KaykyCrespo/cinto-inteligente-deteccao-quedas/README.md

# Cinto Inteligente: detecção de queda e localização indoor (TCC MVP)

O cinto (ESP32-C3 + MPU6050 + AD8232) envia leituras cruas a 100 Hz por BLE (GATT) para uma antena,
que repassa por MQTT. As demais antenas escutam os anúncios BLE e medem RSSI. No PC, o painel Streamlit
monta janelas de 2,5 s, calcula 8 características, roda um Random Forest treinado no SisFall, estima o
quadrante do ambiente, dispara alerta no Telegram e persiste tudo em SQLite.

## Onde está cada documentação

| Arquivo | Conteúdo |
|---|---|
| `README.md` (este) | Visão geral, estrutura, instalação e execução |
| [`Arduino/README_FIRMWARE.md`](Arduino/README_FIRMWARE.md) | Firmware do cinto e da antena: protocolo BLE/MQTT, configuração, Mosquitto |
| [`dados/README_BANCO_DE_DADOS.md`](dados/README_BANCO_DE_DADOS.md) | Banco SQLite: DER, modelos lógico e físico, dicionário de dados |
| [`docs/MANUAL/Manual_Usuario_Operacao_Revisado.pdf`](docs/MANUAL/Manual_Usuario_Operacao_Revisado.pdf) | Guia do Usuário e Manual de Operação revisado (fonte: `docs/MANUAL/MANUAL_USUARIO_OPERACAO.md`) |
| [`docs/impressao_3d`](docs/impressao_3d/) | Projetos `Case Cinto.3mf` e `Case Antena.3mf` para impressão dos cases |
| [`dados/testes`](dados/testes/) | Registros e vídeos de testes; limites de comprovação e rastreabilidade na Seção 5.6 do manual |
| [`docs/VIDEO TECNICO/Roteiro_Video.pdf`](docs/VIDEO%20TECNICO/Roteiro_Video.pdf) | Roteiro e materiais do vídeo técnico (fonte: `docs/VIDEO TECNICO/ROTEIRO_VIDEO.md`) |
| [`docs/gerar_documentos.py`](docs/gerar_documentos.py) | Gera o manual ou o roteiro em DOCX e PDF |
| [`dados/SISFALL/README_ORIGEM_SISFALL.md`](dados/SISFALL/README_ORIGEM_SISFALL.md) | Nota original sobre a origem do dataset SisFall (terceiros) |
| `dados/SISFALL/SisFall_dataset/Readme.txt` | Descrição oficial do SisFall (atividades, voluntários, sensores) |

## Estrutura do projeto

```
TCC MVP/
├── app.py                 painel Streamlit (ponto de entrada)
├── alerta_telegram.py     envio de alertas pelo bot do Telegram
├── banco.py               persistência SQLite (sessões, amostras, janelas, quedas, status)
├── detector_queda.py      janelas + Random Forest em tempo real
├── features.py            as 8 características (referência para treino e detecção)
├── interface.py           parser do pacote MQTT e monitor de terminal
├── localizacao.py         RSSI -> distância -> quadrante (com confiança e retenção)
├── requirements.txt       dependências do sistema
├── requirements-docs.txt  dependências só para gerar documentos e diagramas
├── Arduino/               firmware do cinto (cinto_mvp_v1), da antena (anchor_mvp_v1) e bibliotecas usadas
├── assets/                logo.svg do painel
├── modelos/               modelo_mvp_8g.joblib e o relatório do treino
├── scripts/               treino_sisfall.py, reproduzir_csv.py
├── tests/                 testes automatizados (localização, controle do Telegram)
├── dados/
│   ├── oqpnb.db           banco SQLite (criado ao abrir o painel; ignorado pelo git)
│   ├── README_BANCO_DE_DADOS.md  DER, modelos e dicionário de dados
│   ├── ambiente.json      tamanho do ambiente e posição das antenas (salvo pelo painel)
│   ├── gravacoes/         CSV de amostras do botão "Gravar amostras" (ignorado pelo git)
│   ├── testes/            registros e vídeos de execução dos testes
│   ├── ensaios_rssi/      CSVs e resultados dos ensaios de calibração de RSSI
│   └── SISFALL/           dataset público usado no treino
└── docs/
    ├── MANUAL/            fonte e arquivos PDF/DOCX do manual
    ├── impressao_3d/      projetos Case Cinto.3mf e Case Antena.3mf
    ├── VIDEO TECNICO/     roteiro, gravações e arquivos PDF/DOCX
    ├── gerar_documentos.py gera o manual e o roteiro em DOCX/PDF
    ├── Power Point - Apresentação.pptx
    ├── esquemas/          diagramas (arquitetura, pipeline, métricas) e seus scripts
    ├── APOIO/             material de apoio do curso
    └── IMAGENS/           cases, fluxograma e capturas do painel
```

Os módulos Python da raiz se importam entre si pelo nome; mantenha-os juntos. Scripts e testes
ajustam o `sys.path` sozinhos e podem ser executados de qualquer pasta.

## Instalação e execução

```powershell
git clone https://github.com/KaykyCrespo/cinto-inteligente-deteccao-quedas.git
cd cinto-inteligente-deteccao-quedas

pip install -r requirements.txt

# só para regenerar diagramas e o manual em docs/ (exige Word instalado para o PDF)
pip install -r requirements-docs.txt

# painel (abre http://localhost:8501)
python -m streamlit run app.py

# alerta Telegram (opcional): defina antes de abrir o painel
$env:OQPNB_TG_TOKEN="token do BotFather"; $env:OQPNB_TG_CHAT="chat_id"

# monitor em terminal
python interface.py --modelo modelos/modelo_mvp_8g.joblib --quiet

# reproduzir um CSV gravado sem hardware
python scripts/reproduzir_csv.py dados/gravacoes/amostras_X.csv --modelo modelos/modelo_mvp_8g.joblib

# refazer o treino (~6 min)
python scripts/treino_sisfall.py --sisfall dados/SISFALL/SisFall_dataset --saida modelos/modelo_mvp_8g.joblib

# testes
python -m unittest discover -s tests -p "teste_*.py" -v
```

Variáveis de ambiente opcionais: `OQPNB_BROKER`, `OQPNB_PORT`, `OQPNB_MODELO`, `OQPNB_DB`,
`OQPNB_LARGURA_M`, `OQPNB_ALTURA_M`, `OQPNB_RSSI_1M`, `OQPNB_N_PERDA`, `OQPNB_OFFSET_GATT`.
O tamanho do ambiente e a posição das antenas também podem ser ajustados no painel (mapa da aba
Detalhes); o painel salva em `dados/ambiente.json`, que tem prioridade sobre as variáveis.

Credenciais nunca ficam no código versionado: o token e o chat do Telegram vêm das variáveis
`OQPNB_TG_TOKEN`/`OQPNB_TG_CHAT` ou do arquivo local `segredos.env` (copie de `segredos.env.exemplo`),
e o Wi-Fi das antenas vem de `Arduino/anchor_mvp_v1/credenciais.h` (copie de `credenciais_exemplo.h`).
Os dois arquivos são ignorados pelo git.

As faixas do `iniciarMPU()` no cinto (±8 g / ±2000 °/s) **precisam** ser as mesmas do modelo.
Se mudar alguma, treine de novo com `--faixa-acc` e `--faixa-giro`.

## Painel

- **Monitoramento**: cartão por cinto (status normal / possível queda com data, hora, antena, quadrante
  e contagem regressiva do aviso), broker, amostras, taxa, eletrodos, antenas online, Telegram,
  probabilidade de queda (8 últimas janelas, 0–100 %) e tabela de quedas.
- **Detalhes**: status do sistema (modelo, limiar, pacotes inválidos, amostras perdidas, janelas
  reiniciadas, quantidade de quedas), antenas (GATT/Advertising, RSSI, mais perto), tabela RSSI,
  histórico de quedas, gráficos de sinais, mapa indoor com raios de distância, ECG e exportação.
- **Barra lateral**: envio de alertas no Telegram (toggle + teste), limiar, tempo para resetar o
  aviso de queda (1–5 min), atualização automática, gravação de amostras e reconectar.

## Detecção

Random Forest (200 árvores) treinado offline no SisFall a 100 Hz, ±8 g / ±2000 °/s, validado por
voluntário: 98,8 % das quedas detectadas e 95,3 % de especificidade (limiar 0,5). Detalhes em
`modelos/resultado_treino_mvp_8g.txt`. O modelo não aprende em uso; para incorporar novos dados é
preciso retreinar. Entre dois alarmes do mesmo cinto há um silêncio de 5 s.

## Localização

Estimativa por RSSI das 3 antenas (modelo log-distância), mediana de 4 s, histerese de 0,6 m,
confirmação de 3 s para troca de quadrante e retenção da última posição válida por até 6 s com
baixa confiança. O mapa desenha um círculo por antena com o raio estimado.

Limite conhecido e medido (`dados/ensaios_rssi/RESULTADO_ENSAIOS_RSSI.txt`): com o cinto na frente do corpo,
os ensaios antigos de 1 m com antenas altas mostram uma diferença de cerca de 22 a 24,5 dB
entre a antena de frente e a de costas, compatível com sombreamento, sem isolar outras causas.
Os novos ensaios de 1, 2, 3, 5 e 7 m não mostram queda monotônica de RSSI com a distância nominal;
suas condições de montagem e distâncias até cada antena ainda precisam ser confirmadas.
O relatório reúne estatísticas por antena e origem, agregadas por segundo, sem alterar a calibração.
A trilateração deve ser lida como estimativa de região/quadrante, não de ponto. Próximo passo:
repetir os ensaios com geometria e orientação controladas antes de ajustar o modelo.

## Banco de dados

SQLite em `dados/oqpnb.db`. Janelas, quedas e status das antenas são gravados sempre; amostras
brutas só enquanto "Gravar amostras" estiver ligado. Modelagem completa (DER, lógico, físico,
dicionário de dados) em `dados/README_BANCO_DE_DADOS.md`. A aba Detalhes exporta CSV por sessão e o próprio `.db`.
