KaykyCrespo/cinto-inteligente-deteccao-quedas/docs/Power Point - Apresentação.pptx

UNIP
Ciência da Computação
2026

ORIENTADOR
Prof. Marco Gomes

Vertente SmartCity

Cinto Inteligente com IoT e Inteligência Artificial para Monitoramento de Atividades, Sinais Vitais e Localização Indoor

Sistema de Detecção de Possíveis Quedas

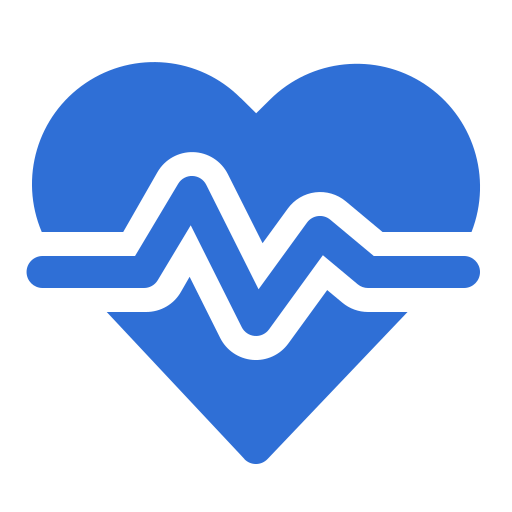
[picture p15: figure]

EQUIPE

Aluisio Pereira Alves (N135891)

Erick de Brito Carvalho (G78HED3)

Enzo Orlandi Gomes (G788EJ5)

Kayky Crespo dos Santos (G839226)

Notes: Boa noite a todos. Somos a equipe formada por Aluisio, Enzo, Erick e Kayky, e apresentamos, sob orientação do professor Marco Gomes, nosso trabalho de conclusão de curso em Ciência da Computação na UNIP. O projeto se chama Cinto Inteligente com IoT e Inteligência Artificial para Monitoramento de Atividades, Sinais Vitais e Localização Indoor, e tem como foco um sistema de detecção de possíveis quedas. Ele se enquadra na vertente SmartCity, porque trata do cuidado com idosos como um serviço urbano apoiado por tecnologia. Nos próximos minutos vamos mostrar o contexto do problema, o que propomos, como fundamentamos a solução e como o protótipo foi construído. Vamos começar pela introdução.

## Slide 2

Quedas de idosos são um desafio urbano

População envelhecendo

Cresce o número de pessoas idosas nas cidades.

Cinto Inteligente – TCC UNIP 2026

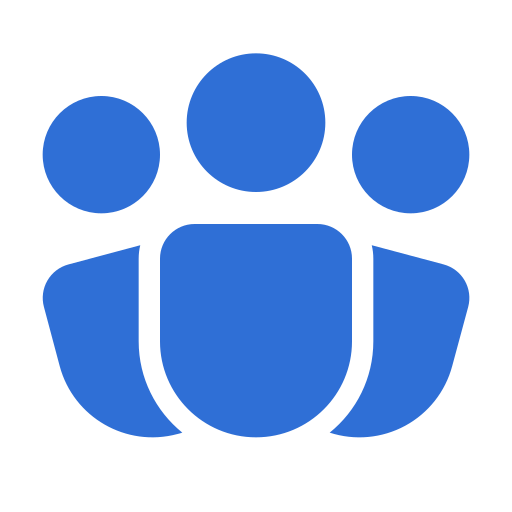
[picture p16: figure]

Quedas frequentes e graves

Podem causar lesões sérias e perda de autonomia.

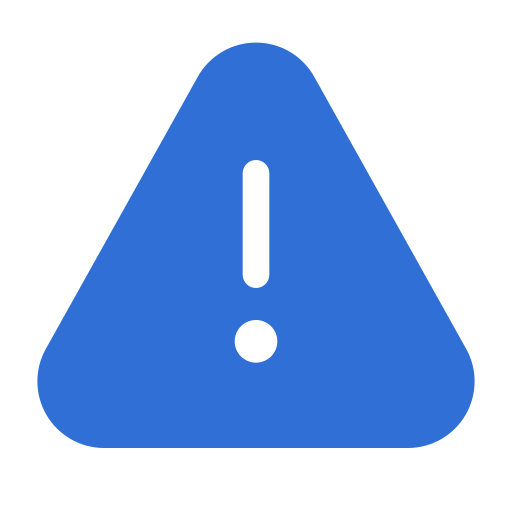
[picture p17: figure]

Cuidar é serviço urbano

Casas de repouso, unidades de saúde e atendimento domiciliar.

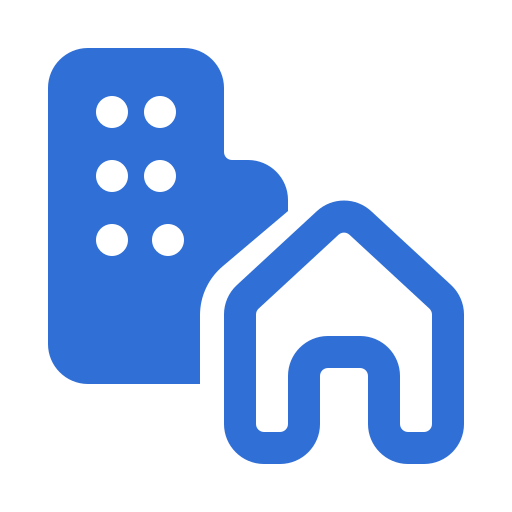
[picture p18: figure]

2

Notes: Vamos começar pelo contexto. A população brasileira e a mundial estão envelhecendo, e isso muda a forma como as cidades precisam se organizar. Entre os riscos associados ao envelhecimento, as quedas se destacam: elas são frequentes e, em idosos, costumam ser graves, podendo levar a lesões sérias, internações e perda de autonomia. Por isso, o cuidado com a pessoa idosa deixou de ser apenas uma questão familiar e passou a ser também um serviço urbano. Ele acontece em casas de repouso, em unidades de saúde e no atendimento domiciliar, ambientes onde a tecnologia pode ajudar equipes e familiares a agir mais rápido. É nesse cenário que nosso projeto se insere, e é por isso que ele pertence à vertente SmartCity.

## Slide 3

Por que este projeto importa

Ajuda mais rápida

Reduzir o tempo entre a queda e a chegada de ajuda.

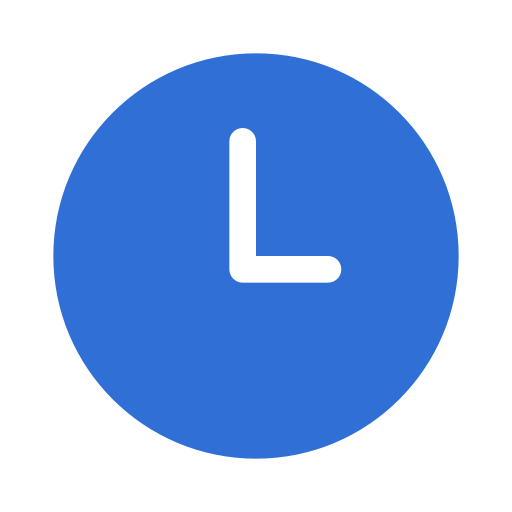
[picture p19: figure]

Privacidade preservada

Monitorar sem câmeras.

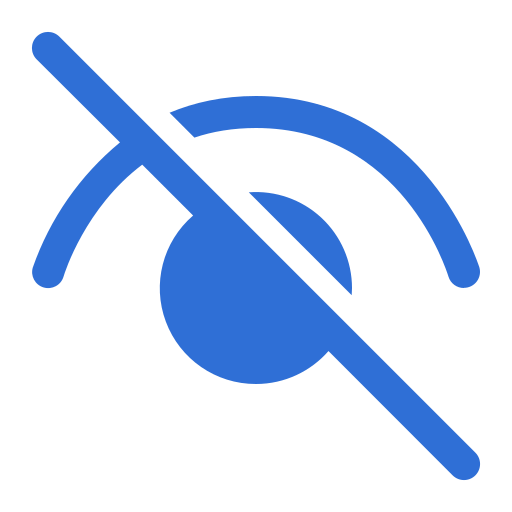
[picture p20: figure]

Inovação frugal

Usar componentes de baixo custo.

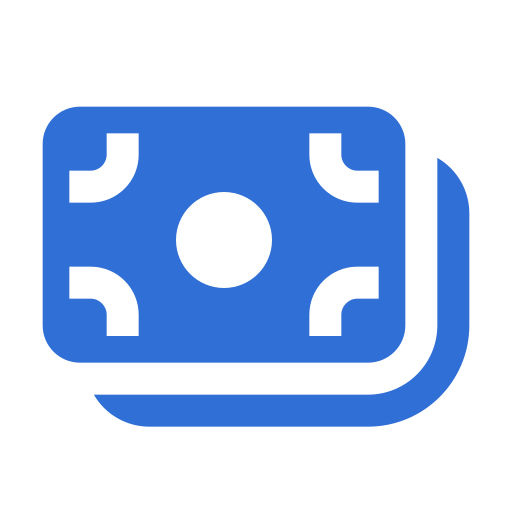
[picture p21: figure]

Cinto Inteligente – TCC UNIP 2026

3

Notes: Três ideias sustentam a justificativa do trabalho. A primeira é reduzir o tempo entre a queda e a chegada de ajuda. Em uma queda, cada minuto conta, e uma pessoa que fica no chão sem ser notada pode sofrer consequências ainda mais graves. A segunda é monitorar sem câmeras. Ao usar sensores vestidos no corpo, em vez de imagens, preservamos a privacidade da pessoa idosa dentro da sua própria casa ou da instituição. A terceira é a inovação frugal: usamos componentes de baixo custo, como microcontroladores ESP32 e sensores simples, para que a solução possa ser acessível e replicável em diferentes realidades. Juntas, essas três ideias mostram que a proposta é útil, respeitosa e viável.

## Slide 4

Soluções atuais ainda falham

Como detectar quedas automaticamente e saber onde elas ocorreram dentro de casa?

Cinto Inteligente – TCC UNIP 2026

Botão de acionamento

Depende de quem caiu conseguir apertar.

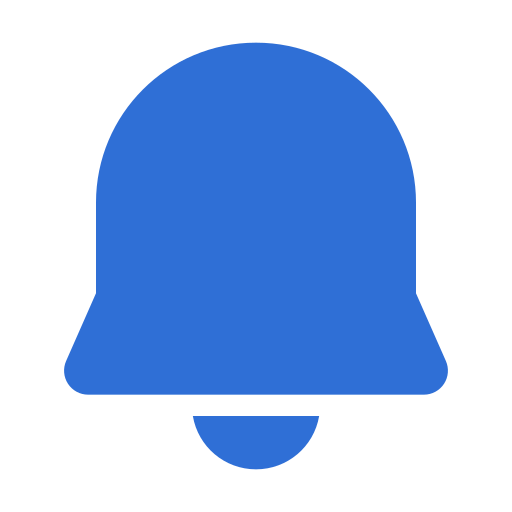
[picture p22: figure]

GPS

Falha dentro de casa.

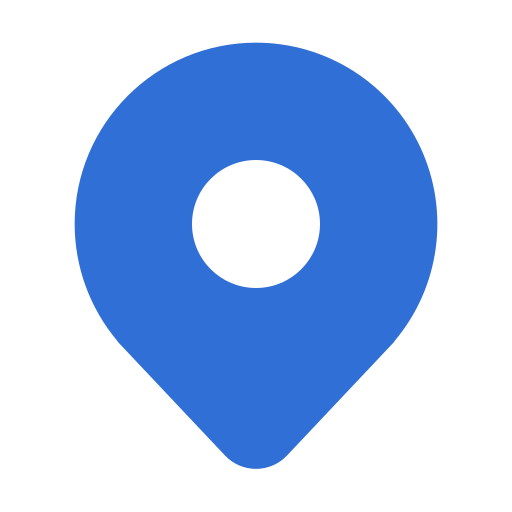
[picture p23: figure]

Alarmes falsos

Disparam avisos sem queda real.

4

Notes: Chegamos ao problema de pesquisa. Hoje, as soluções disponíveis para idosos que moram sozinhos ou são assistidos têm três limitações principais. Primeiro, muitas dependem de um botão que precisa ser acionado por quem caiu, e justamente quem sofre uma queda grave pode estar desacordado ou sem condições de apertar. Segundo, vários dispositivos usam GPS, que funciona bem na rua, mas falha dentro de casa, onde não há visão do céu; assim, a equipe até sabe que algo aconteceu, mas não sabe em qual cômodo. Terceiro, há sistemas que disparam alarmes falsos, o que gera cansaço e faz as pessoas perderem a confiança no alerta. Daí surge nossa pergunta: como detectar quedas automaticamente e saber onde elas ocorreram dentro de casa?

## Slide 5

O que nos propusemos a fazer

OBJETIVO GERAL

Detectar possíveis quedas automaticamente e indicar a região do ambiente onde ocorreram.

Cinto Inteligente – TCC UNIP 2026

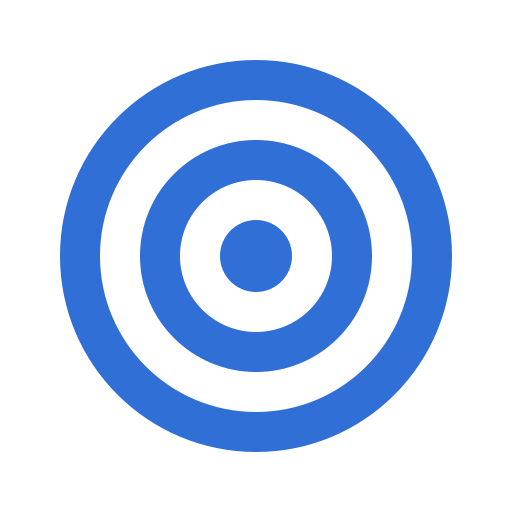
[picture p24: figure]

OBJETIVOS ESPECÍFICOS

Construir um cinto com sensor de movimento e ECG

1

2

3

4

Instalar 3 antenas Bluetooth para localizar o cinto

Treinar um modelo de IA (Random Forest)

Criar um painel web com alerta no Telegram

5

Notes: Com o problema definido, estabelecemos nossos objetivos. O objetivo geral é detectar possíveis quedas automaticamente e indicar a região do ambiente onde elas ocorreram. Para chegar lá, definimos quatro objetivos específicos. O primeiro é construir um cinto que reúna um sensor de movimento e um sensor de ECG. O segundo é instalar três antenas Bluetooth pelo ambiente, que permitem localizar onde o cinto está. O terceiro é treinar um modelo de inteligência artificial, usando o algoritmo Random Forest, para reconhecer quedas a partir dos dados de movimento. E o quarto é criar um painel web que mostre as informações e envie um alerta pelo Telegram para quem cuida da pessoa. Cada objetivo corresponde a uma parte do sistema que vamos detalhar na arquitetura.

## Slide 6

Base teórica do projeto

Cidades inteligentes e saúde conectada
Giffinger et al., 2007; Zanella et al., 2014

1

2

3

4

5

Internet das Coisas
Bluetooth e MQTT

Random Forest
Breiman, 2001

Dataset SisFall de quedas
Sucerquia et al., 2017

Localização por intensidade de sinal
RSSI

Cinto Inteligente – TCC UNIP 2026

6

Notes: A fundamentação teórica se apoia em cinco pilares. O primeiro é o conceito de cidades inteligentes e saúde conectada, discutido por Giffinger e colaboradores em 2007 e por Zanella e colaboradores em 2014, que mostram como a tecnologia pode melhorar serviços urbanos. O segundo é a Internet das Coisas, com o uso de Bluetooth e do protocolo MQTT para levar os dados dos dispositivos até o sistema. O terceiro é o Random Forest, algoritmo de aprendizado de máquina proposto por Breiman em 2001, que usamos para classificar os movimentos. O quarto é o dataset SisFall, de Sucerquia e colaboradores, de 2017, que reúne registros de quedas e de atividades do dia a dia para treinar e validar o modelo. E o quinto é a localização por intensidade de sinal, o RSSI, que nos permite estimar a região onde o cinto está.

## Slide 7

Como desenvolvemos e validamos

Pesquisa aplicada e experimental

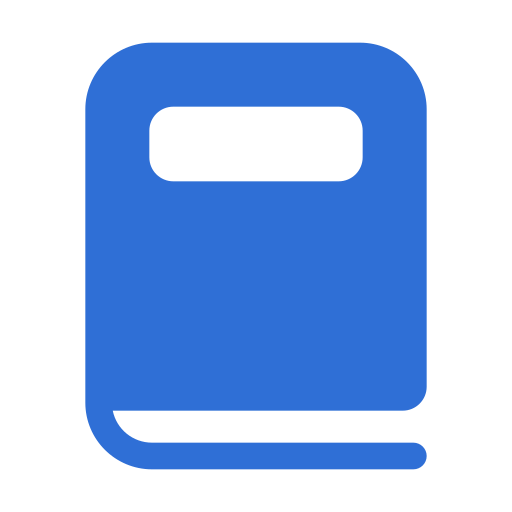
[picture p25: figure]

MODELO VALIDADO COM O SISFALL

38

voluntários

Desenvolvimento iterativo

1.798

quedas

Testes do protótipo em ambiente controlado

Cinto Inteligente – TCC UNIP 2026

2.707

atividades do dia a dia

7

Notes: Do ponto de vista metodológico, nosso trabalho é uma pesquisa aplicada e experimental: buscamos resolver um problema prático e testamos a solução na prática. O desenvolvimento foi iterativo, ou seja, construímos o sistema em ciclos, testando e melhorando cada parte, do cinto até o painel. O modelo de inteligência artificial foi treinado e validado com o dataset SisFall, que reúne dados de 38 voluntários, com 1.798 registros de quedas e 2.707 registros de atividades do dia a dia, como caminhar, sentar e levantar. Essa diversidade é importante para que o modelo aprenda a diferenciar uma queda de um movimento normal e, assim, gere menos alarmes falsos. Por fim, o protótipo foi testado em ambiente controlado, para verificar o funcionamento do conjunto antes de qualquer uso real.

## Slide 8

Arquitetura em 5 camadas

Borda
ESP32-C3, MPU6050, AD8232 (ECG)

1

2

Conectividade
3 antenas, Bluetooth, Wi-Fi, MQTT

Persistência
Banco SQLite

3

4

5

Inteligência
Random Forest e localização

Interface
Painel web e alerta no Telegram

Cinto Inteligente – TCC UNIP 2026

8

Notes: Para terminar, a arquitetura do sistema, organizada em cinco camadas. A primeira é a Borda: o cinto, que reúne um microcontrolador ESP32-C3, o sensor de movimento MPU6050 e o sensor de ECG AD8232. A segunda é a Conectividade: três antenas ESP32 espalhadas pelo ambiente recebem o sinal Bluetooth do cinto e enviam os dados por Wi-Fi, usando o protocolo MQTT. A terceira é a Persistência, com um banco de dados SQLite que guarda os registros. A quarta é a Inteligência, onde o modelo Random Forest identifica a possível queda e a localização indica a região do ambiente. A quinta é a Interface: um painel web e um alerta enviado pelo Telegram. Agradecemos a atenção e ficamos à disposição da banca para perguntas.

## Slide 9

Hardware do protótipo

Cinto

- ESP32-C3
- Sensor de movimento MPU6050
- Módulo de ECG AD8232
- 2 baterias 18650
- Carregador TP4056
- Conversor MT3608 (5 V)
- Case impresso em 3D

Cinto Inteligente – TCC UNIP 2026

Antena (3 unidades)

- ESP32 DevKit
- 1 bateria 18650
- TP4056
- MT3608
- Case impresso em 3D

Foto do cinto

Foto da antena

9

Notes: Neste slide mostramos o hardware do protótipo, que é formado por dois tipos de dispositivo. O primeiro é o cinto, que o idoso usa. Ele tem um microcontrolador ESP32-C3, o sensor de movimento MPU6050 e o módulo de ECG AD8232. Para funcionar sem fio, usa duas baterias 18650, com carregador TP4056 e um conversor MT3608 que eleva a tensão para 5 volts. Tudo fica dentro de um case impresso em 3D. O segundo é a antena, da qual usamos três unidades espalhadas pelo ambiente. Cada uma tem um ESP32 DevKit, uma bateria 18650, o carregador TP4056, o conversor MT3608 e também um case impresso em 3D. Reparem que são componentes comuns e de baixo custo, o que reforça a proposta de inovação frugal. Ao lado de cada lista, mostramos uma foto do cinto e uma foto da antena montados.

## Slide 10

Como a IA detecta a queda

ETAPA 1

100/s

Leitura do movimento 100 vezes por segundo

ETAPA 2

2,5 s

Janela de 2,5 segundos, atualizada a cada 0,5 s

ETAPA 3

8

características: aceleração, rotação, inclinação, variação brusca e repouso após o impacto

ETAPA 4

200

Modelo Random Forest com 200 árvores

ETAPA 5

Alerta

Probabilidade de queda acima do limiar gera o alerta

Treinado com o dataset SisFall e validado em voluntários que o modelo nunca viu

Cinto Inteligente – TCC UNIP 2026

10

Notes: Aqui mostramos, em cinco etapas, como a inteligência artificial detecta uma possível queda. Na primeira etapa, o sensor de movimento do cinto é lido 100 vezes por segundo, o que dá uma visão bem detalhada do movimento. Na segunda, esses dados são agrupados em uma janela de 2,5 segundos, que é atualizada a cada meio segundo, então o sistema está sempre analisando os últimos instantes. Na terceira, calculamos 8 características a partir de cada janela: aceleração, rotação, inclinação, variação brusca e repouso após o impacto. Esse último é importante, porque depois de uma queda a pessoa costuma ficar parada. Na quarta etapa, essas características entram no modelo Random Forest, formado por 200 árvores de decisão que votam juntas. Na quinta, se a probabilidade de queda ficar acima de um limiar, o sistema gera o alerta. Por fim, destacamos que o modelo foi treinado com o dataset SisFall e validado em voluntários que ele nunca viu, o que mostra que ele consegue generalizar e não apenas decorar os dados de treino.

## Slide 11

Resultados do modelo

98,8%

Recall

Detectou 1.777 de 1.798 quedas

93,3%

Precisão

96,0%

F1-score

95,3%

Especificidade

96,7%

Acurácia

Matriz de confusão

Validação cruzada por voluntário (5 partes) no dataset SisFall

Cinto Inteligente – TCC UNIP 2026

11

Notes: Estes são os resultados do modelo, obtidos com validação cruzada por voluntário, em cinco partes, no dataset SisFall. Isso significa que o modelo sempre foi testado em voluntários que não participaram do seu treinamento. O principal destaque é o Recall de 98,8%: das 1.798 quedas do dataset, o modelo detectou 1.777. Em um sistema de segurança, essa é a métrica mais importante, porque queremos perder o mínimo possível de quedas reais. A Precisão foi de 93,3%, ou seja, a maior parte dos alertas disparados corresponde a quedas de verdade. O F1-score, que equilibra precisão e recall, ficou em 96,0%. A Especificidade foi de 95,3%, mostrando que o modelo reconhece bem as atividades do dia a dia e gera poucos alarmes falsos. E a Acurácia geral foi de 96,7%. À direita, apresentamos a matriz de confusão, que detalha os acertos e os erros do modelo.

## Slide 12

Localização e limitações

Como funciona

3 antenas medem a força do sinal Bluetooth do cinto

Limitações

O corpo bloqueia o sinal (cerca de 22 dB): localização por região, não por ponto exato

1

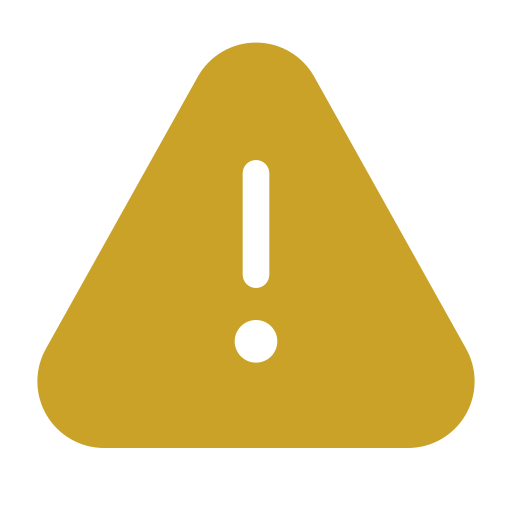
[picture p26: figure]

O sistema estima a distância de cada antena

2

Quedas do dataset foram simuladas por voluntários

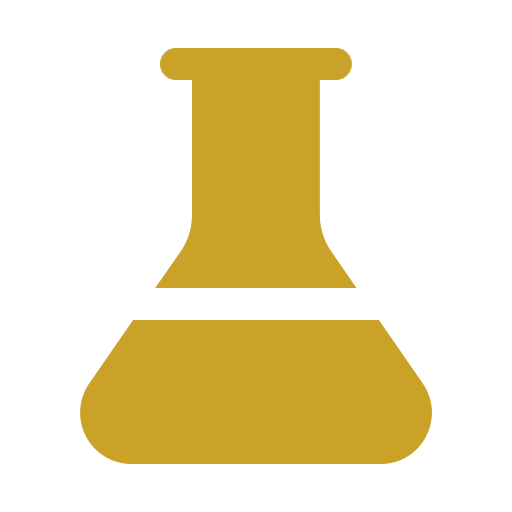
[picture p27: figure]

ECG experimental, sem finalidade médica

O resultado indica o quadrante do ambiente

Cinto Inteligente – TCC UNIP 2026

3

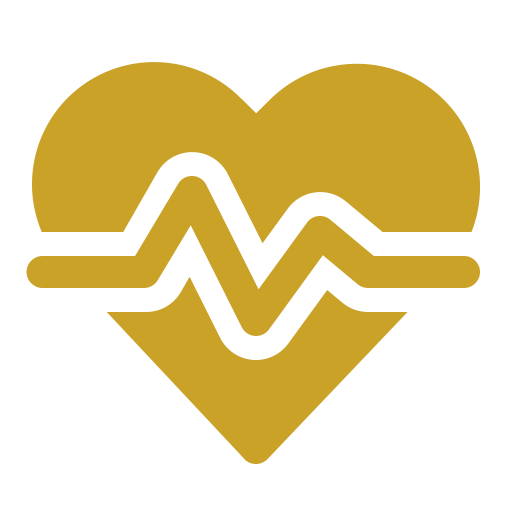
[picture p28: figure]

Autonomia da bateria ainda curta

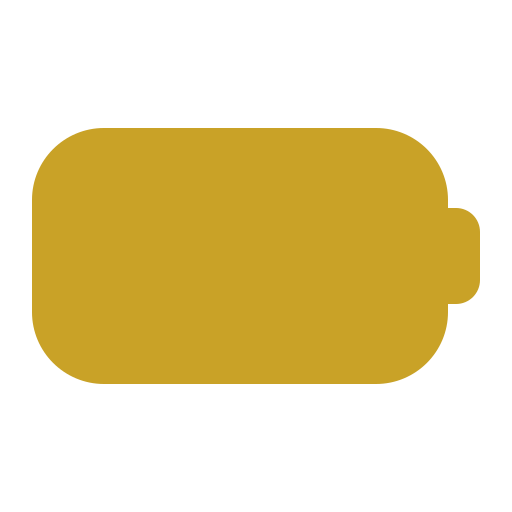
[picture p29: figure]

12

Notes: Este slide explica como funciona a localização e quais são as limitações do protótipo. Na localização, as três antenas medem a força do sinal Bluetooth emitido pelo cinto. Com essa intensidade, o sistema estima a distância entre o cinto e cada antena, e o cruzamento dessas três distâncias indica em qual quadrante do ambiente a pessoa está. Agora, as limitações, que queremos apresentar com transparência. Primeiro, o corpo humano bloqueia o sinal, em cerca de 22 dB, e por isso a localização é feita por região, não por ponto exato. Segundo, as quedas do dataset foram simuladas por voluntários, então podem diferir de quedas reais de idosos. Terceiro, o ECG é experimental e não tem finalidade médica. E quarto, a autonomia da bateria ainda é curta. Essas limitações apontam caminhos claros para trabalhos futuros.

## Slide 13

Demonstração ao vivo

PASSO 1

Ligar o cinto e as 3 antenas

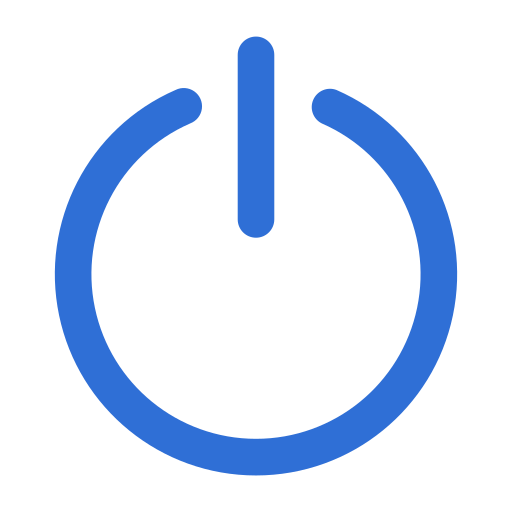
[picture p30: figure]

PASSO 2

Painel recebendo os dados em tempo real

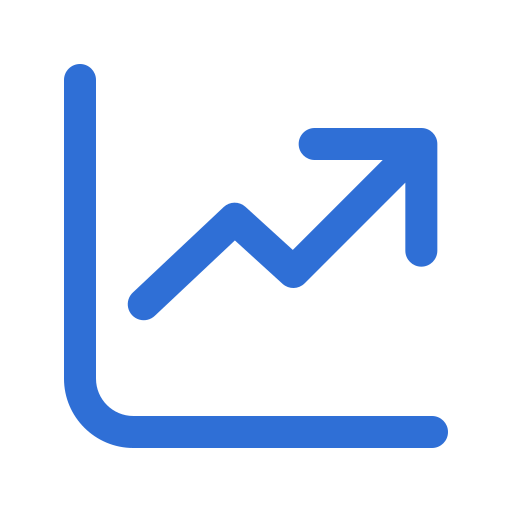
[picture p31: figure]

PASSO 3

Simular uma queda no colchão

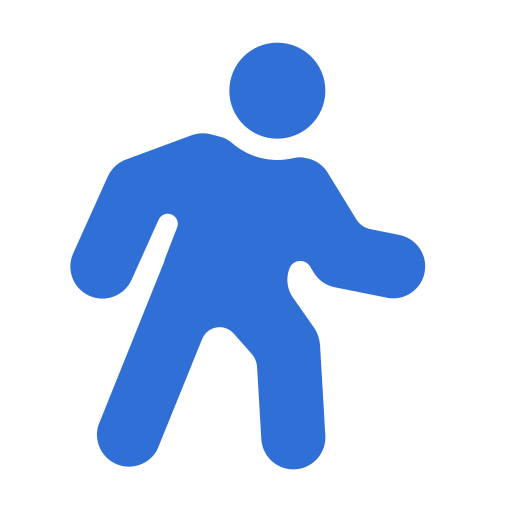
[picture p32: figure]

PASSO 4

Alerta no painel e no Telegram com a antena mais próxima e o quadrante

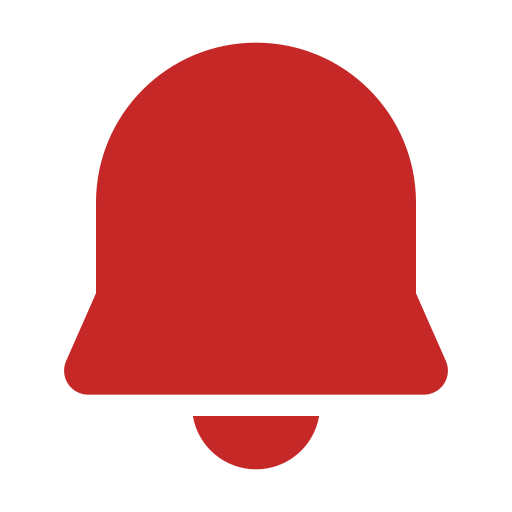
[picture p33: figure]

Cinto Inteligente – TCC UNIP 2026

13

Notes: Chegou o momento da demonstração ao vivo, que segue quatro passos. Primeiro, vamos ligar o cinto e as três antenas, que se conectam e começam a trabalhar. Segundo, mostramos o painel web recebendo os dados em tempo real, com movimento e localização sendo atualizados na tela. Terceiro, vamos simular uma queda sobre um colchão, de forma segura, para que o cinto registre o impacto e o modelo analise o movimento. Quarto, observem o alerta aparecendo no painel e chegando também no Telegram, com a indicação da antena mais próxima e do quadrante onde a queda aconteceu. Assim, vocês acompanham todo o caminho: do cinto até o aviso para quem cuida da pessoa.

## Slide 14

Conclusão e trabalhos futuros

Conclusão

Detecta possíveis quedas de forma automática e em tempo real

Trabalhos futuros

Validar o modelo com quedas gravadas pelo próprio cinto

1

1

Melhorar a localização

2

Funciona sem câmeras e com baixo custo

2

Aumentar a autonomia da bateria

3

Avisa a equipe de cuidado pelo Telegram

3

Integrar a centrais de teleassistência da cidade

4

Cinto Inteligente – TCC UNIP 2026

14

Notes: Para concluir: o cinto inteligente que desenvolvemos detecta possíveis quedas de forma automática e em tempo real, sem usar câmeras e com baixo custo, e avisa a equipe de cuidado pelo Telegram. Com isso, atingimos o objetivo de reduzir o tempo entre a queda e a chegada de ajuda, preservando a privacidade da pessoa idosa. Sobre trabalhos futuros, vemos quatro caminhos. Primeiro, validar o modelo com quedas gravadas pelo próprio cinto, e não apenas com o dataset SisFall. Segundo, melhorar a localização, tornando-a mais precisa. Terceiro, aumentar a autonomia da bateria. E quarto, integrar o sistema a centrais de teleassistência da cidade, o que reforça seu papel como serviço urbano dentro da vertente SmartCity. Agradecemos a atenção de todos e ficamos à disposição da banca para perguntas.

## Slide 15

EQUIPE

Aluisio Pereira Alves
Enzo Orlandi Gomes
Erick de Brito Carvalho
Kayky Crespo dos Santos

ORIENTADOR

Prof. Marco Gomes

UNIP – Ciência da Computação – 2026

Obrigado!
Perguntas?

github.com/KaykyCrespo/cinto-inteligente-deteccao-quedas

Notes: Chegamos ao fim da apresentação. Agradecemos a atenção de todos, ao nosso orientador, professor Marco Gomes, e à banca avaliadora. O código do projeto está disponível publicamente no GitHub, no endereço que aparece na tela, para quem quiser consultar ou reproduzir o protótipo. Ficamos à disposição para as perguntas da banca.
