KaykyCrespo/cinto-inteligente-deteccao-quedas/docs/VIDEO TECNICO/Imagens para Vídeo.pptx

ESPAÇO RESERVADO

Logo oficial da UNIP

Inserir o arquivo oficial anexado (não recriar)

ESPAÇO RESERVADO

Logo do projeto

Inserir o logo do projeto, se disponível

Protótipo de detecção de possíveis quedas

BLOCO 1 · CAPA

Cinto Inteligente com IoT e Inteligência Artificial para Monitoramento de Atividades, Sinais Vitais e Localização Indoor

Vertente: SmartCity

EQUIPE [inserir o nome da equipe]

Kayky Crespo dos Santos · Aluisio Pereira Alves · Erick de Brito Carvalho · Enzo Orlandi Gomes

Cinto Inteligente – TCC UNIP 2026

## Slide 2

BLOCO 1 · POR QUE SMARTCITY

Por que SmartCity?

Serviço urbano

Casa de repouso, unidade de saúde e residência

Infraestrutura de sensores

Antenas num prédio enviam dados por MQTT a um computador local

Escala

Vários prédios conectados a uma central de cuidado

1

2

3

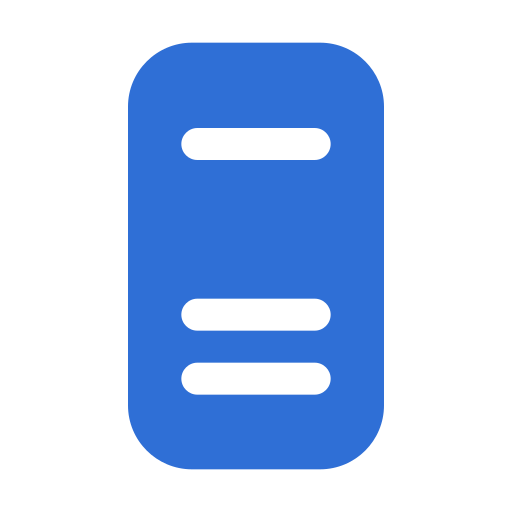
[picture p34: figure]
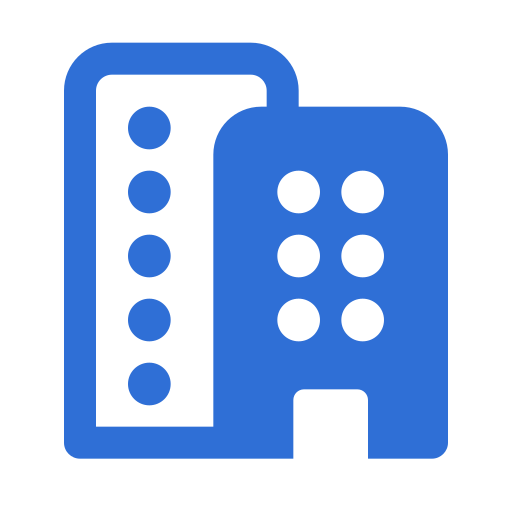
[picture p35: figure]
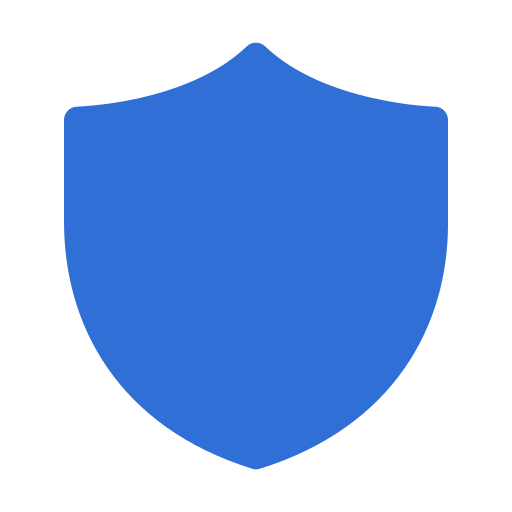
[picture p36: figure]

Protótipo acadêmico: a escala é uma visão de evolução da arquitetura, não uma implantação existente em vários prédios.

Cinto Inteligente – TCC UNIP 2026

2

## Slide 3

BLOCO 2 · PROBLEMA E PROPOSTA

Do problema atual a um alerta automático

Como é hoje

Nossa proposta

O botão de emergência depende de a pessoa conseguir acioná-lo

O GPS pode falhar em ambientes internos

Movimentos bruscos podem causar alarmes falsos

Alerta automático de possível queda

Sem câmeras

Componentes acessíveis

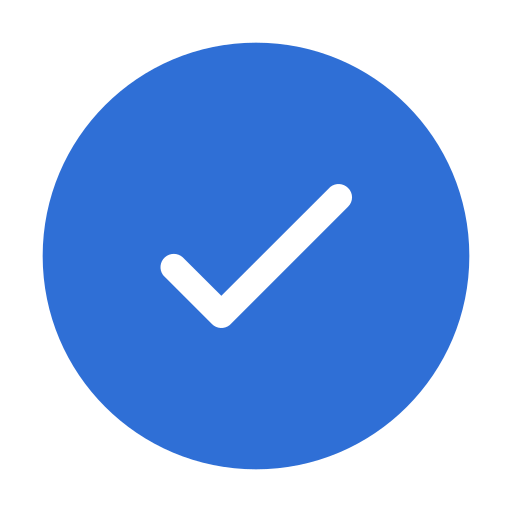
[picture p37: figure]
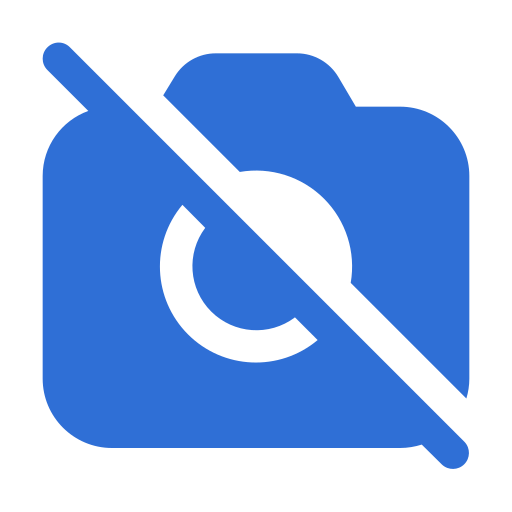
[picture p38: figure]
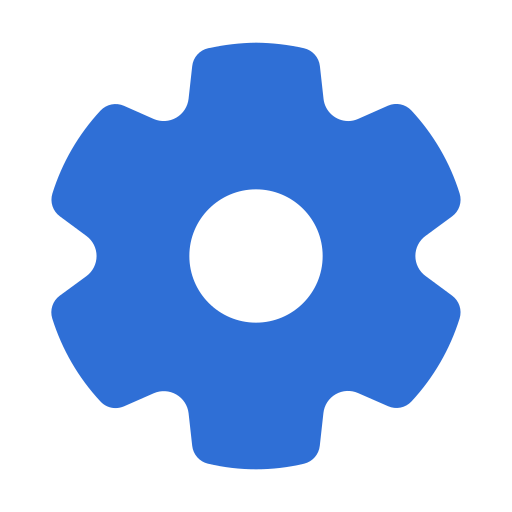
[picture p39: figure]

O sistema indica uma “possível queda”. Não é um diagnóstico médico.

Cinto Inteligente – TCC UNIP 2026

3

## Slide 4

BLOCO 2 · HIPÓTESE E RESULTADOS

Hipótese e resultados de validação

HIPÓTESE
Um modelo Random Forest pode detectar quedas automaticamente a partir dos dados de movimento.

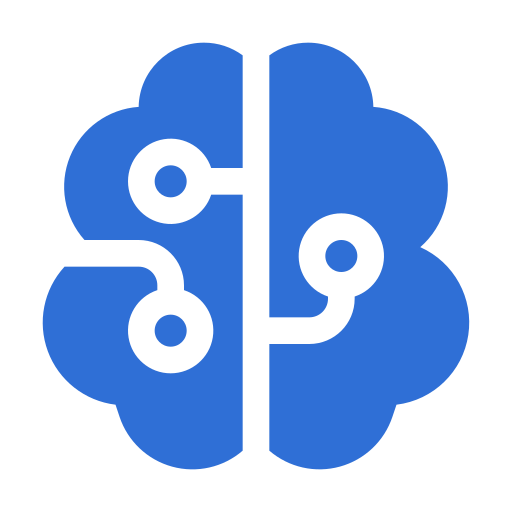
[picture p40: figure]

RECALL (SENSIBILIDADE)

98,8%

das 1.798 quedas foram detectadas

ESPECIFICIDADE

95,3%

das 2.707 atividades normais foram classificadas corretamente

Resultados do modelo no dataset SisFall (validação GroupKFold). Não são uma garantia de desempenho clínico.

Cinto Inteligente – TCC UNIP 2026

4

## Slide 5

BLOCO 3 · ARQUITETURA

Do cinto ao alerta: o percurso dos dados

Cinto e sensores
ESP32-C3 · MPU6050 · AD8232

Três antenas ESP32
Região do cinto pelo RSSI

Mosquitto no computador
Computador local

SQLite, modelo e localização

Painel Streamlit e Telegram

BLE/GATT e anúncios

Wi-Fi/MQTT

ESPAÇO RESERVADO

Diagrama de arquitetura em cinco camadas

Inserir o arquivo arquitetura_camadas.png (não anexado). Preservar os nomes das camadas e a arquitetura real.

Cinto Inteligente – TCC UNIP 2026

Sem câmeras

Sem processamento em nuvem

Localização por região ou quadrante, não ponto exato

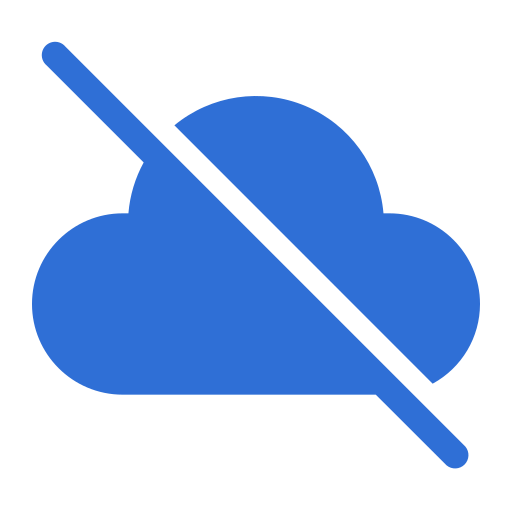
[picture p41: figure]

5

## Slide 6

BLOCO 4 · HARDWARE · ACOMPANHA FILMAGEM REAL DO PROTÓTIPO ABERTO E DA ANTENA

Hardware do protótipo

FOTO

ESP32-C3

Foto real

FOTO

MPU6050

Foto real

FOTO

AD8232

Foto real

FOTO

TP4056

Foto real

ESPAÇO RESERVADO

Esquema elétrico

inserir esquema elétrico final

FOTO

MT3608

Foto real

FOTO

Baterias 18650

Foto real

FOTO

ESP32 DevKit

Foto real da antena

5,0 V

medidos na saída do MT3608

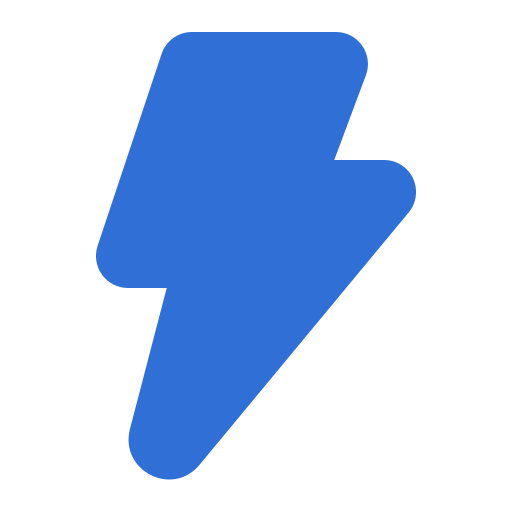
[picture p42: figure]

Cinto Inteligente – TCC UNIP 2026

6

## Slide 7

BLOCO 5 · DADOS E PIPELINE DE IA

Do dataset SisFall ao modelo em operação

TREINO OFFLINE

SISFALL

38 voluntários

1.798 quedas simuladas e 2.707 atividades normais

AMOSTRAGEM

200 → 100 Hz

Dados adaptados

JANELAS

2,5 s

Passo de 0,5 s

BASE DE TREINO

122.572

janelas e 8 atributos

MODELO

Random Forest

Treinado offline

OPERAÇÃO EM TEMPO REAL

Amostras do cinto

Janela de 2,5 s

8 atributos

Modelo treinado

Probabilidade de queda

ESPAÇO RESERVADO

Imagem do pipeline de IA

Inserir pipeline_ia.png (não anexado), se disponível

Cinto Inteligente – TCC UNIP 2026

7

## Slide 8

BLOCO 6 · MODELO E VALIDAÇÃO

Random Forest e validação por voluntário

RANDOM FOREST

Muitas árvores de decisão analisam a mesma janela e votam.

GROUPKFOLD · 5 PARTES, SEPARADAS POR VOLUNTÁRIO

MATRIZ DE CONFUSÃO

| Previsto: queda | Previsto: normal
Real: queda | 1.777 quedas detectadas | 21 não detectadas
Real: normal | 128 alarmes falsos | 2.579 atividades normais corretas

MÉTRICAS DE VALIDAÇÃO

8 atributos

Árvore 1

Votação das árvores: probabilidade de queda

Árvore 2

Árvore …

Rodada 1

Rodada 2

Teste

Treino

Treino

Teste

Treino

Treino

Treino

Treino

Treino

Treino

98,8%

Recall

95,3%

Especificidade

93,3%

Precisão

96%

F1

96,7%

Acurácia

Rodada 3

Treino

Treino

Teste

Treino

Treino

Rodada 4

Rodada 5

Treino

Treino

Treino

Treino

Treino

Treino

Teste

Treino

Treino

Teste

Tabela editável; substituir por matriz_confusao.png (não anexada), se preferir. Resultados no SisFall.

Em cada rodada, os voluntários de teste não aparecem no treino.

Cinto Inteligente – TCC UNIP 2026

8

## Slide 9

BLOCO 6 · INFERÊNCIA EM TEMPO REAL

Como uma possível queda é detectada

Receber amostras

1

Formar janela

2

Calcular atributos

3

Estimar probabilidade

4

Comparar com o limiar

5

Registrar possível queda e alertar

6

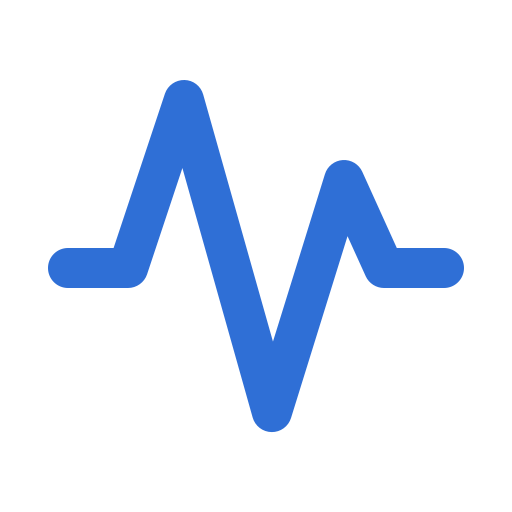
[picture p43: figure]
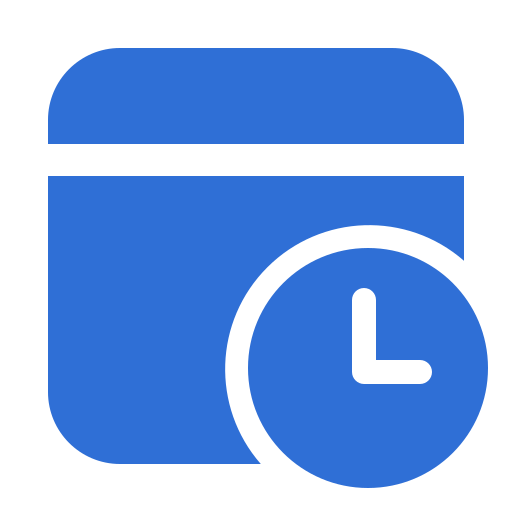
[picture p44: figure]
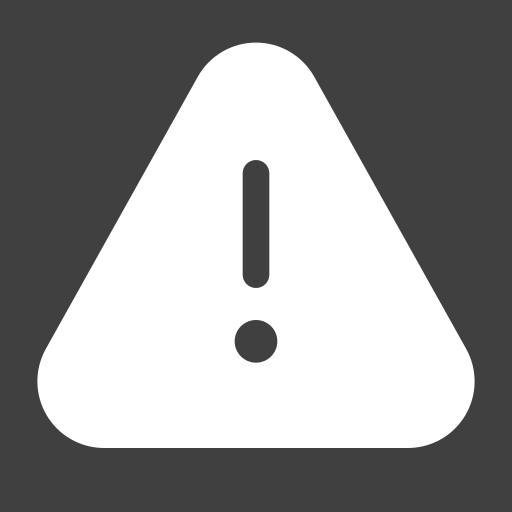
[picture p45: figure]

ESPAÇO RESERVADO

Gravação real do terminal

Inserir a gravação real do terminal em execução. Não simular a saída do terminal.

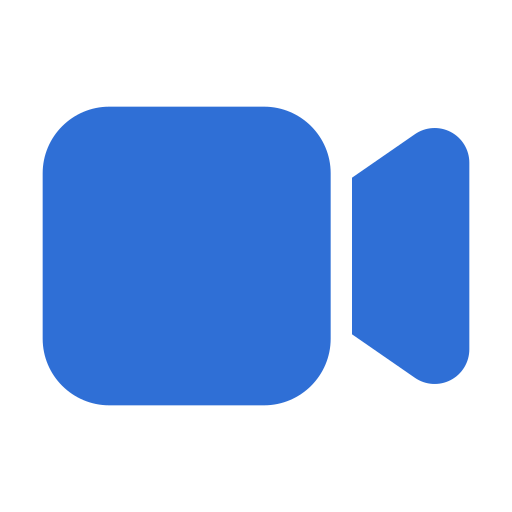
[picture p46: figure]

Cinto Inteligente – TCC UNIP 2026

9

## Slide 10

BLOCO 7 · DEMONSTRAÇÃO

Demonstração do sistema em funcionamento

ESPAÇO RESERVADO

Filmagem real

Pessoa usando o cinto. Inserir a filmagem real.

ESPAÇO RESERVADO

Captura real do painel

Inserir captura real do painel Streamlit.

ESPAÇO RESERVADO

Celular

Inserir captura real do Telegram.

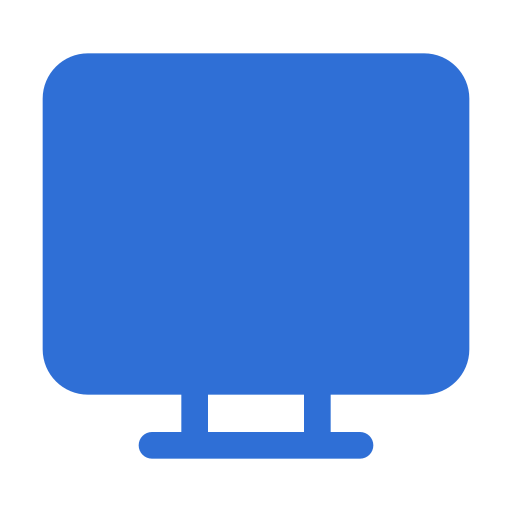
[picture p47: figure]
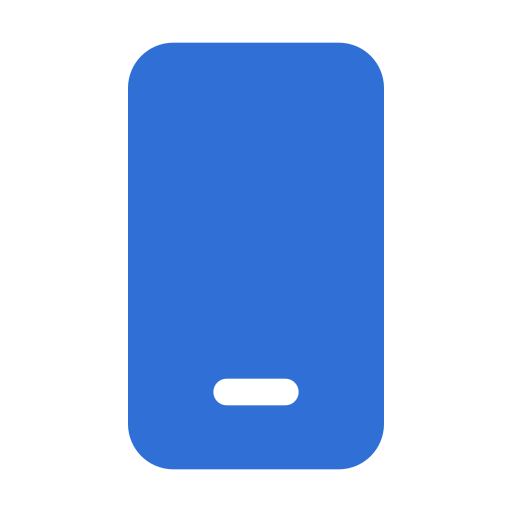
[picture p48: figure]

Antenas online

Status dos eletrodos

ECG

Probabilidade

Alerta de possível queda

Quadrante

Exportação CSV

10

Destaques a mostrar no painel. Não exibir senhas, tokens ou dados pessoais nas capturas.

Cinto Inteligente – TCC UNIP 2026

## Slide 11

BLOCO 8 · RESULTADOS E ENCERRAMENTO

O que entregamos e o que vem a seguir

Entregamos

Resultados

Próximos passos

Cinto com sensores

Três antenas

Painel Streamlit

Alerta pelo Telegram

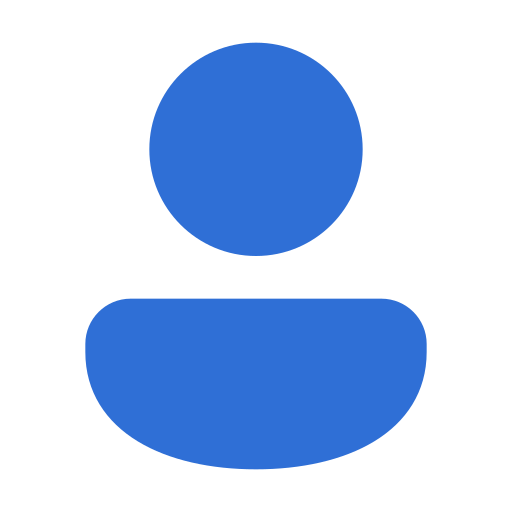
[picture p49: figure]

98,8%

das quedas detectadas

96%

de F1 na validação SisFall

Validar com dados próprios

Melhorar a localização

Aumentar a autonomia da bateria

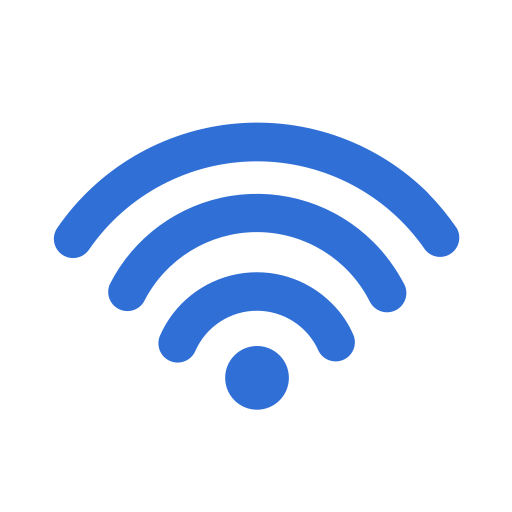
[picture p50: figure]
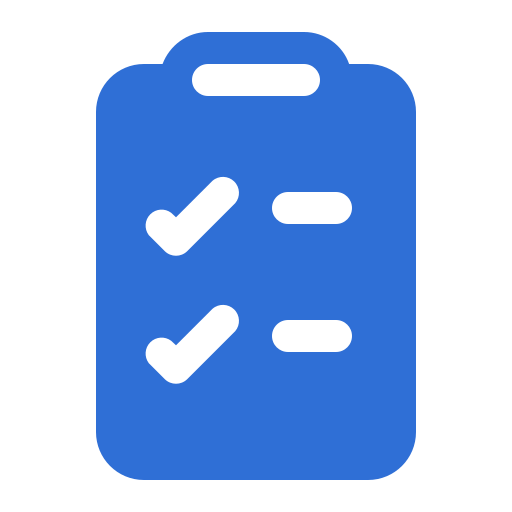
[picture p51: figure]
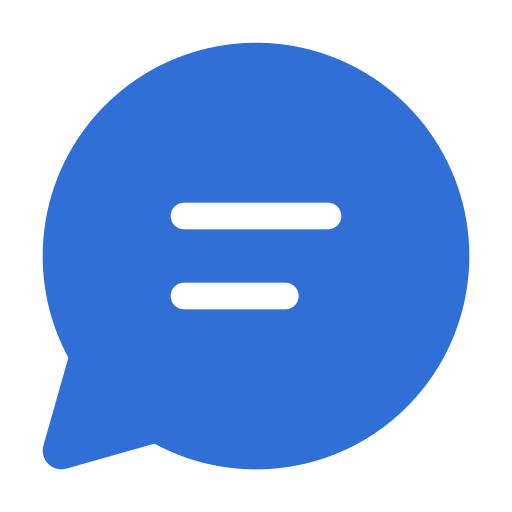
[picture p52: figure]
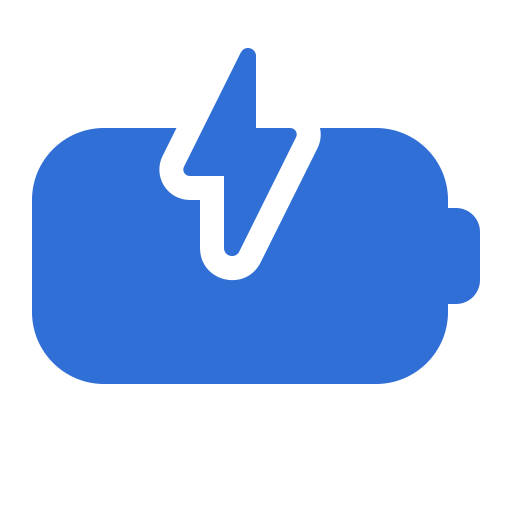
[picture p53: figure]

ESPAÇO RESERVADO

Equipe reunida e o protótipo

Inserir foto ou filmagem real do encerramento

Cinto Inteligente – TCC UNIP 2026

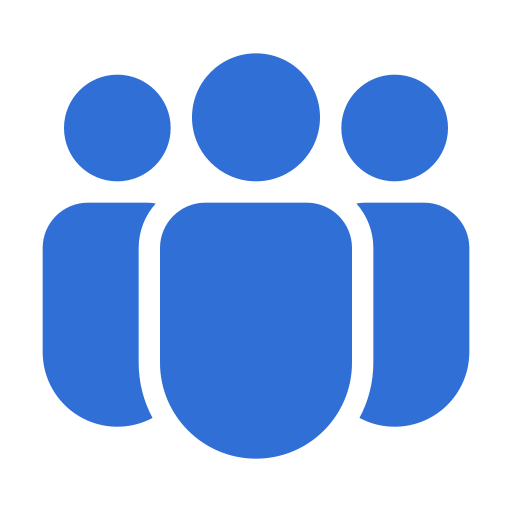
[picture p54: figure]

ECG experimental
Sem finalidade médica. O sistema indica possível queda, não diagnóstico.

11

## Slide 12

APOIO DE EDIÇÃO · TARJAS PARA A CÂMERA

Tarjas da equipe

TARJA 1 · PRIMEIRA FALA

Kayky Crespo dos Santos
Product Owner, gerente de projeto e Scrum Master

TARJA 2 · PRIMEIRA FALA

Aluisio Pereira Alves
Pesquisador e redator

TARJA 3 · PRIMEIRA FALA

Erick de Brito Carvalho
Arquiteto de soluções e desenvolvedor de software

TARJA 4 · PRIMEIRA FALA

Enzo Orlandi Gomes
Responsável pelo sistema embarcado

Copiar cada tarja para o editor de vídeo e sobrepor na primeira fala do integrante. Texto editável; sem fotos.

Cinto Inteligente – TCC UNIP 2026

12
