KaykyCrespo/cinto-inteligente-deteccao-quedas/docs/esquemas/matriz_confusao.pdf

Queda | Atividade sem queda
| Classe prevista

Queda
(1.798 ensaios)

Atividade sem queda
(2.707 ensaios)

### Classe real

1.777 VP · 98,8% | 21 FN · 1,2%
128 FP · 4,7% | 2.579 VN · 95,3%

## Matriz de confusão do detector de quedas

SisFall · GroupKFold por voluntário · 5 folds · limiar 0,50 · 4.505 ensaios

Fonte das figuras: elaborado pelos autores (2026).

Dados: relatório de treinamento no SisFall (resultado_treino_mvp_8g.txt).

Nota: contagens por ensaio; percentuais calculados sobre o total de cada classe real.

VP: verdadeiro positivo; FN: falso negativo; FP: falso positivo; VN: verdadeiro negativo.

Ensaio positivo: ao menos uma janela com probabilidade maior ou igual ao limiar.

Este critério não mede atraso de detecção nem taxa de falsos alarmes por hora.
