KaykyCrespo/cinto-inteligente-deteccao-quedas/docs/esquemas/metricas_modelo.pdf

Sensibilidade
98,8%

VP / (VP + FN)

Precisão
93,3%

VP / (VP + FP)

F1-score
96,0%

2VP / (2VP + FP + FN)

Especificidade
95,3%

VN / (VN + FP)

Acurácia
96,7%

(VP + VN) / total

(a) Sensibilidade e especificidade por limiar
0,00 | 0,05 | 0,10 | 0,15 | 0,20 | 0,25 | 0,30 | 0,35

Redução média de impureza (adimensional)

Desvio padrão de |a|
no fim da janela (post_std)

Magnitude mínima
da aceleração (amin)

Variação máxima de |a|
por segundo (jerk)

Desvio padrão da magnitude da aceleração (astd)

Magnitude máxima
da velocidade angular (gmax)

Magnitude máxima
da aceleração (amax)

Desvio padrão da magnitude da velocidade angular (gstd)

Variação de inclinação
(tilt)

0,04

0,04

0,07

0,08

0,12

0,13

0,18

0,33

(b) Importância no modelo final

## Avaliação do detector de quedas e importância dos atributos

Random Forest · 8 atributos · SisFall · GroupKFold por voluntário · 5 folds · limiar 0,50 · 4.505 ensaios

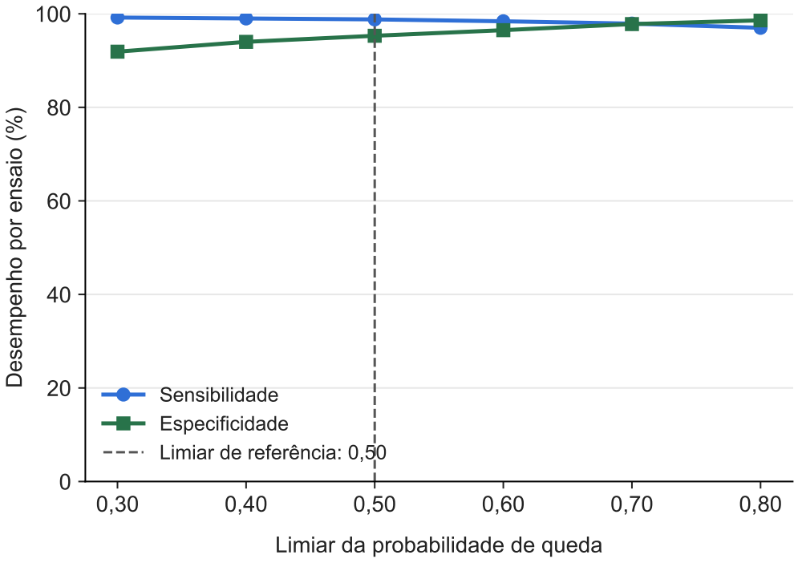
[picture p71: figure]
Limiar da probabilidade de queda; Desempenho por ensaio (%); Sensibilidade; Especificidade; Limiar de referência: 0,50

Fonte das figuras: elaborado pelos autores (2026).
Dados: relatório de treinamento no SisFall (resultado_treino_mvp_8g.txt).
Notas: métricas e painel (a) obtidos por validação cruzada, com voluntários separados entre treino e teste.
Ensaio positivo: ao menos uma janela com probabilidade maior ou igual ao limiar; não mede atraso ou alarmes/hora. Painel (b): importâncias do modelo final treinado em todos os dados; não são métricas de validação nem efeitos causais. Importâncias arredondadas no relatório; a soma apresentada pode diferir de 1. Quedas positivas; atividades negativas. VP (verdadeiro positivo): 1777; FN (falso negativo): 21; FP (falso positivo): 128; VN (verdadeiro negativo): 2579.
