KaykyCrespo/cinto-inteligente-deteccao-quedas/docs/esquemas/esquemas eletricos/Foto Montando.jpeg

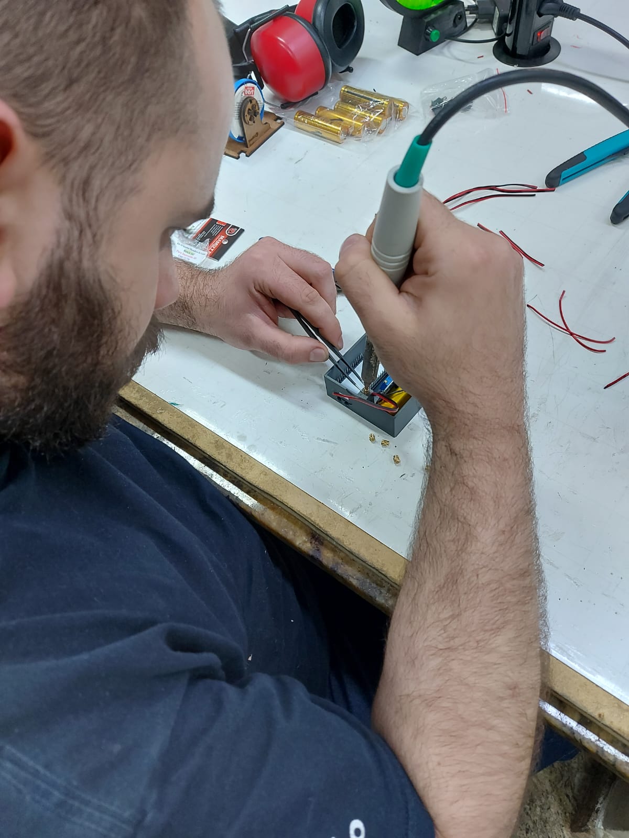
docs/esquemas/esquemas eletricos/Foto Montando.jpeg
