KaykyCrespo/cinto-inteligente-deteccao-quedas/docs/esquemas/esquemas eletricos/Foto Multímetro.jpeg

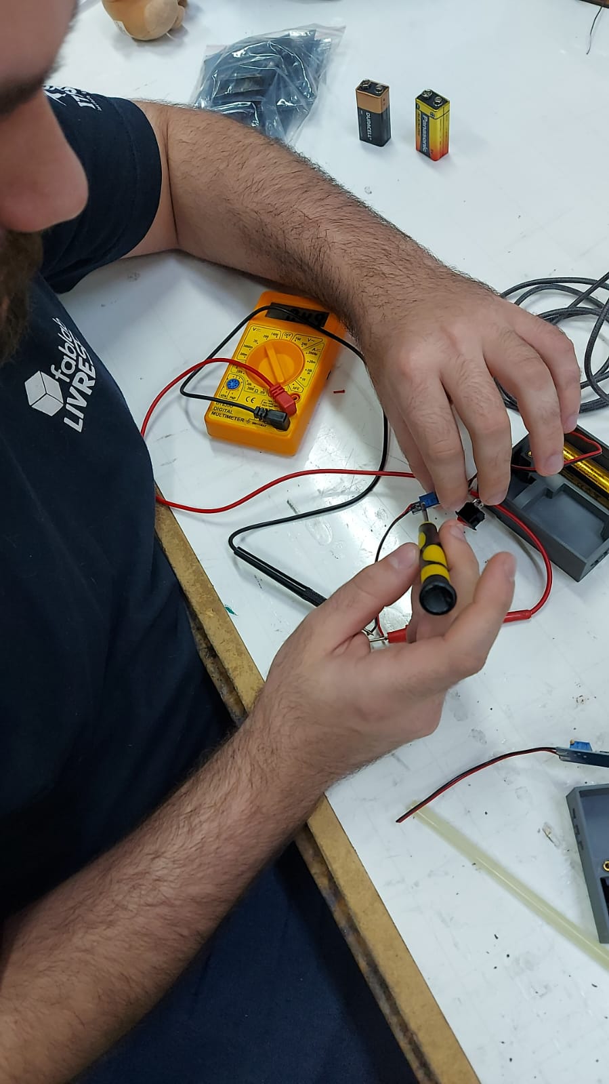
docs/esquemas/esquemas eletricos/Foto Multímetro.jpeg
