KaykyCrespo/cinto-inteligente-deteccao-quedas/docs/esquemas/matriz_confusao.png

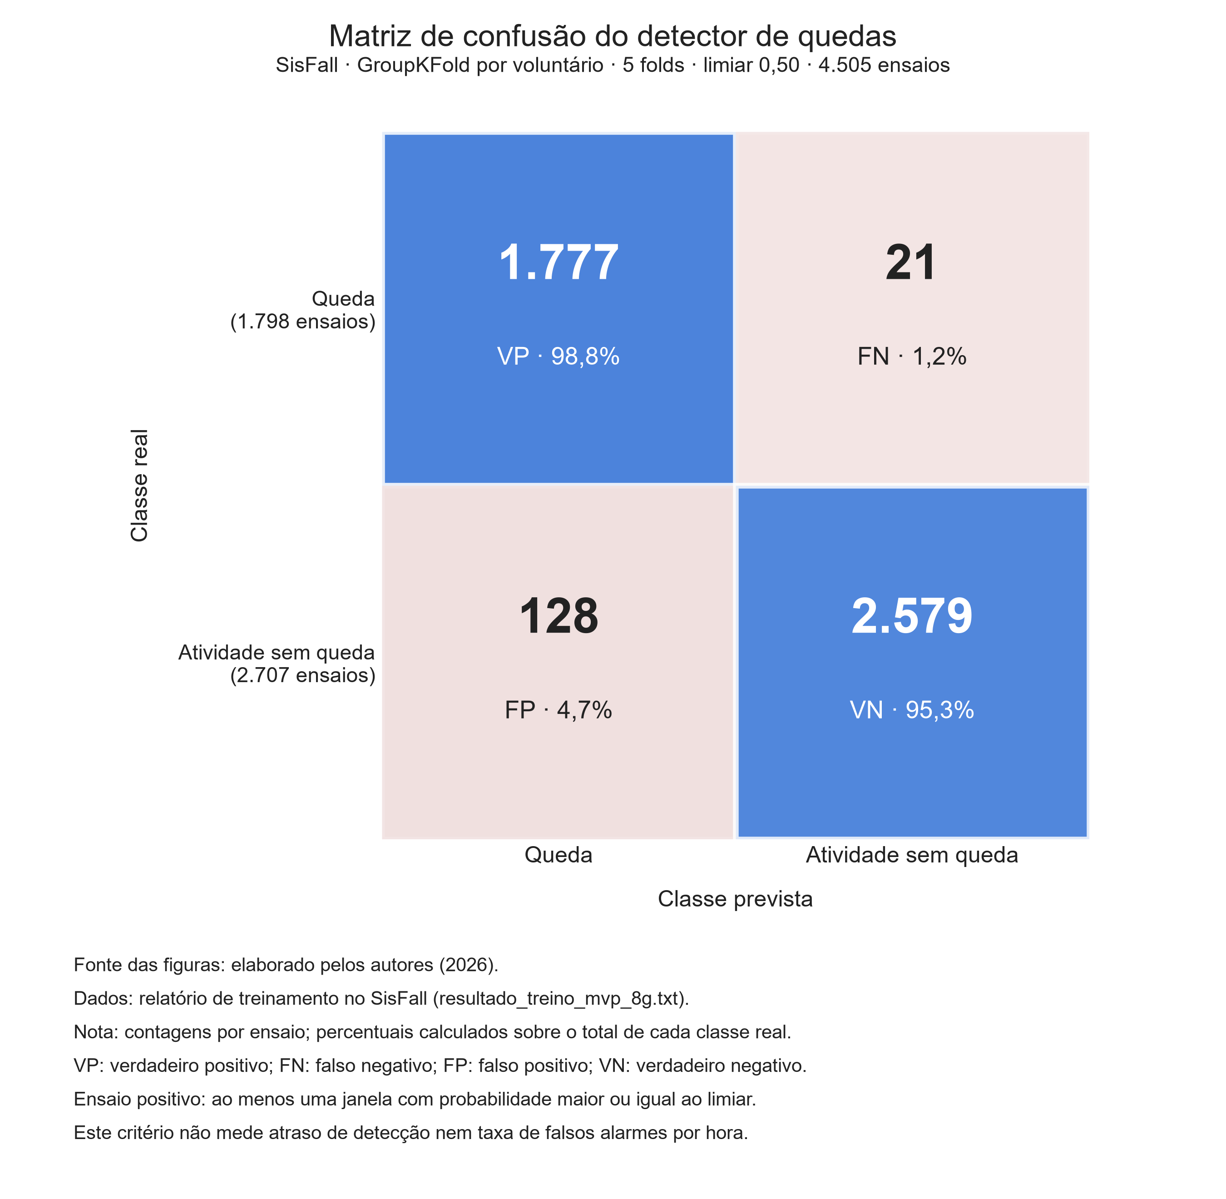
docs/esquemas/matriz_confusao.png
