KaykyCrespo/cinto-inteligente-deteccao-quedas/docs/esquemas/metricas_modelo.png

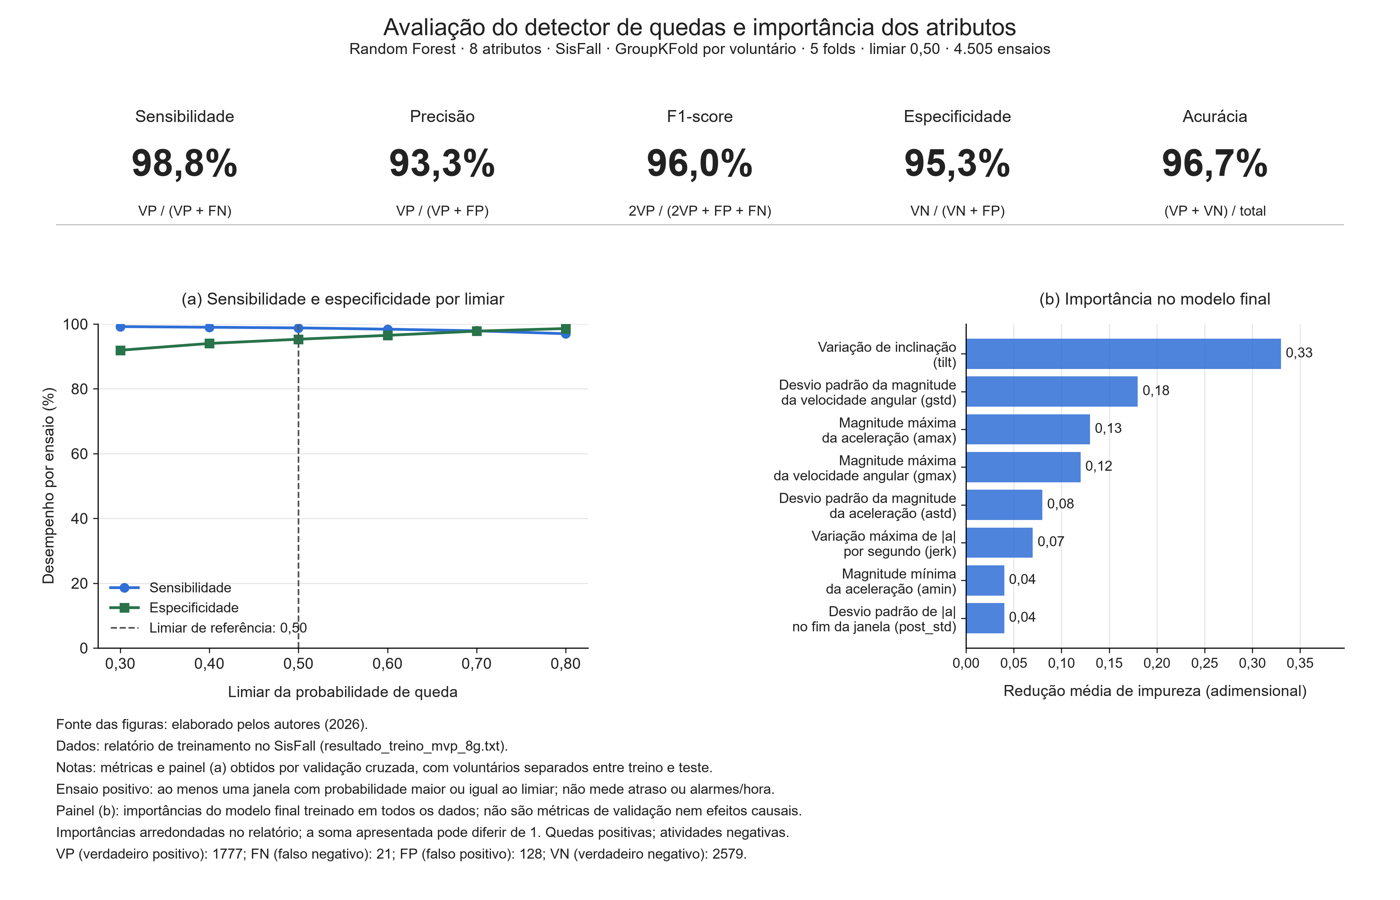
docs/esquemas/metricas_modelo.png
