KaykyCrespo/cinto-inteligente-deteccao-quedas/docs/esquemas/pipeline_ia.png

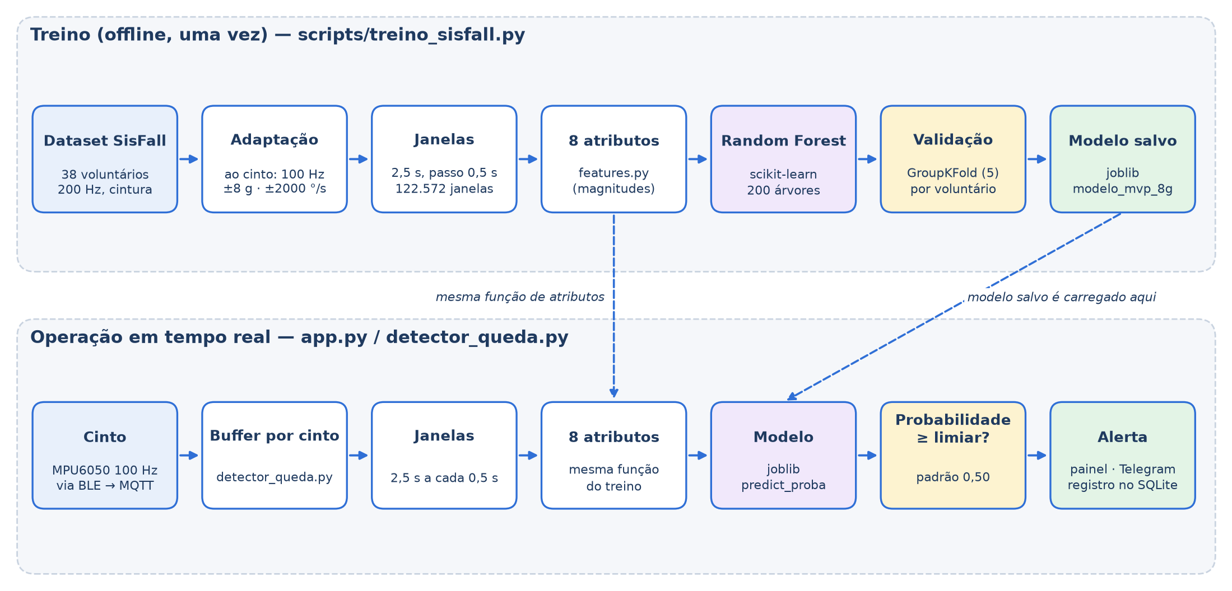
docs/esquemas/pipeline_ia.png
