KaykyCrespo/cinto-inteligente-deteccao-quedas/docs/IMAGENS/Case Cinto/Case Cinto ECG Carregador.jpeg

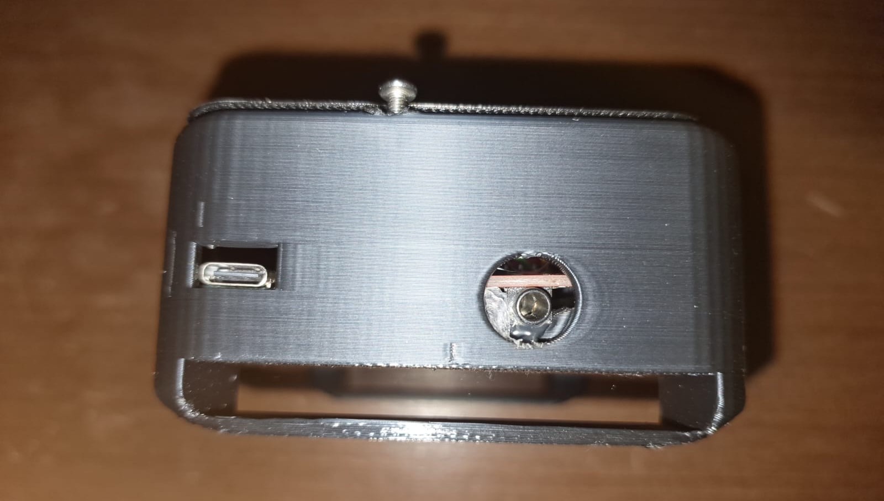
docs/IMAGENS/Case Cinto/Case Cinto ECG Carregador.jpeg
