KaykyCrespo/cinto-inteligente-deteccao-quedas/docs/IMAGENS/Case Cinto/Case Cinto Espmini.jpeg

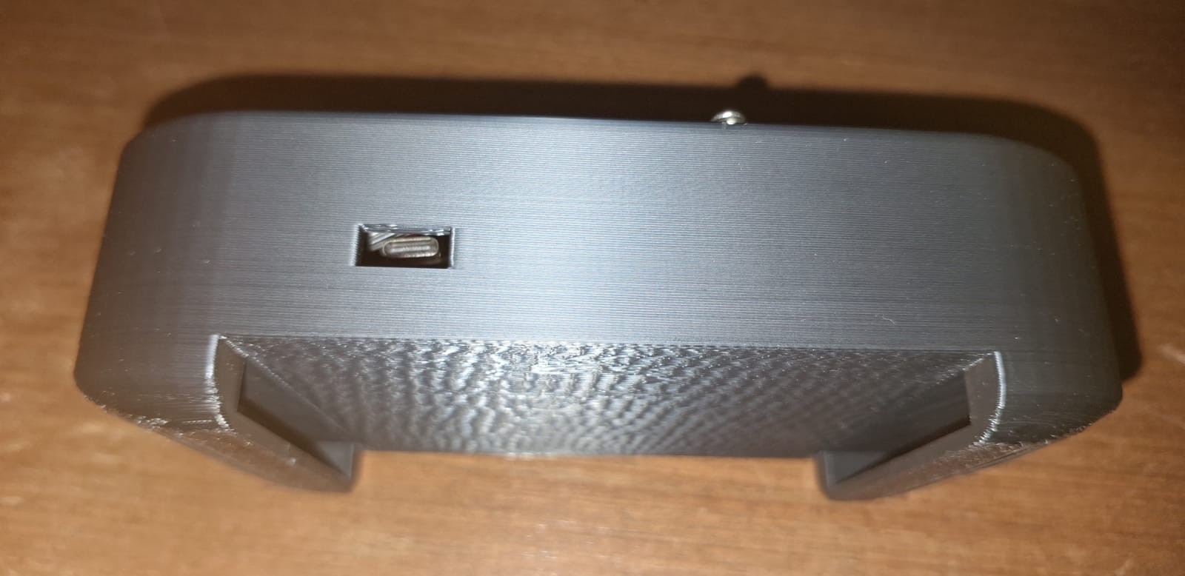
docs/IMAGENS/Case Cinto/Case Cinto Espmini.jpeg
