KaykyCrespo/cinto-inteligente-deteccao-quedas/docs/IMAGENS/Case Cinto/Case Cinto Tampa.jpeg

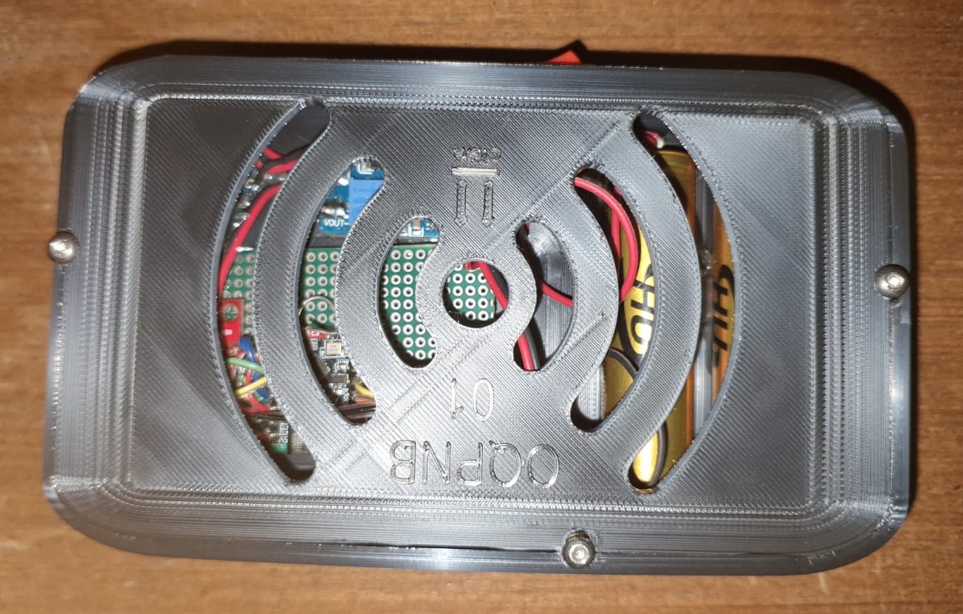
docs/IMAGENS/Case Cinto/Case Cinto Tampa.jpeg
