KaykyCrespo/cinto-inteligente-deteccao-quedas/docs/IMAGENS/Case Cinto/Casse Cinto aberto.jpeg

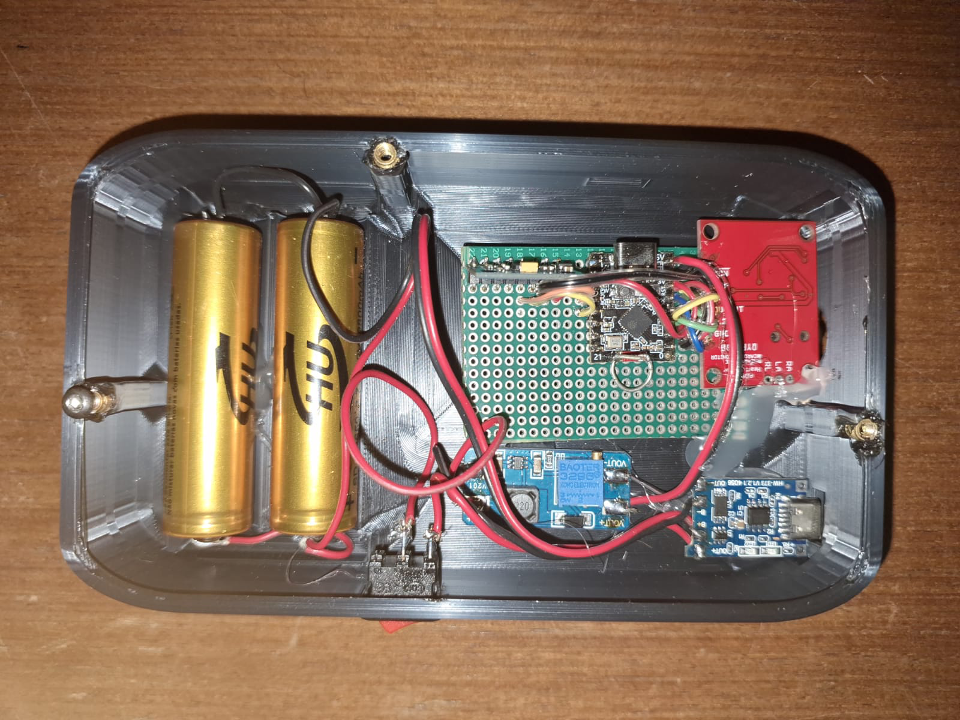
docs/IMAGENS/Case Cinto/Casse Cinto aberto.jpeg
