KaykyCrespo/cinto-inteligente-deteccao-quedas/docs/IMAGENS/Case Cinto/Casse Cinto Chave Gangorra.jpeg

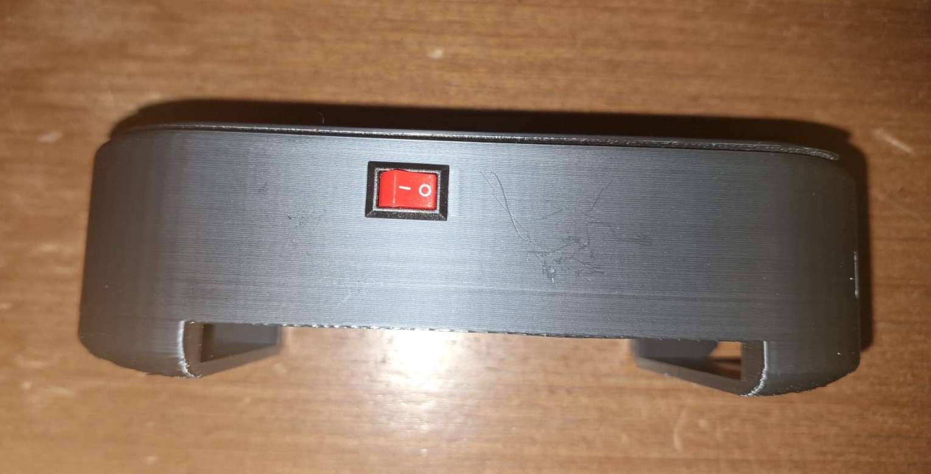
docs/IMAGENS/Case Cinto/Casse Cinto Chave Gangorra.jpeg
