KaykyCrespo/cinto-inteligente-deteccao-quedas/docs/impressao_3d/Case Antena.3mf

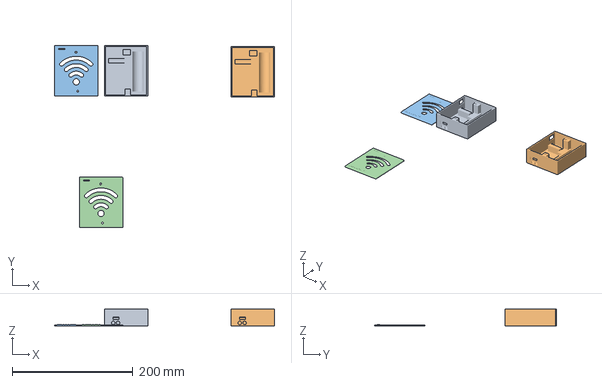
[picture p82: CAD file, 2026-11-10]
docs/impressao_3d/Case Antena.3mf
364.0 x 301.9 x 28.0 mm
obj_1_Body1.stl x 2
obj_2_Body2.stl x 2
