KaykyCrespo/cinto-inteligente-deteccao-quedas/docs/impressao_3d/Case Cinto.3mf

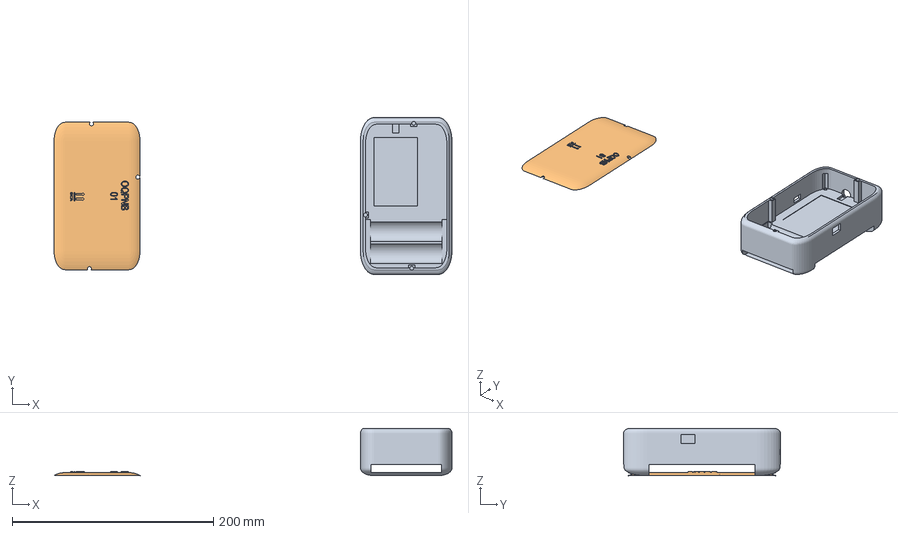
[picture p83: CAD file, 2026-11-10]
docs/impressao_3d/Case Cinto.3mf
395.4 x 156.0 x 47.0 mm
case tcc v2 (1).stl_2
case tcc v2 (1).stl_16
