KaykyCrespo/cinto-inteligente-deteccao-quedas/docs/IMAGENS/prints/barra_lateral.png

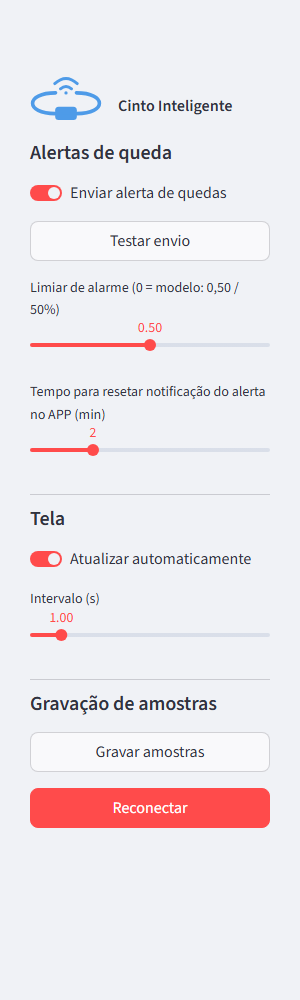
docs/IMAGENS/prints/barra_lateral.png
