KaykyCrespo/cinto-inteligente-deteccao-quedas/docs/IMAGENS/prints/config_localizacao_ECG_.jpeg

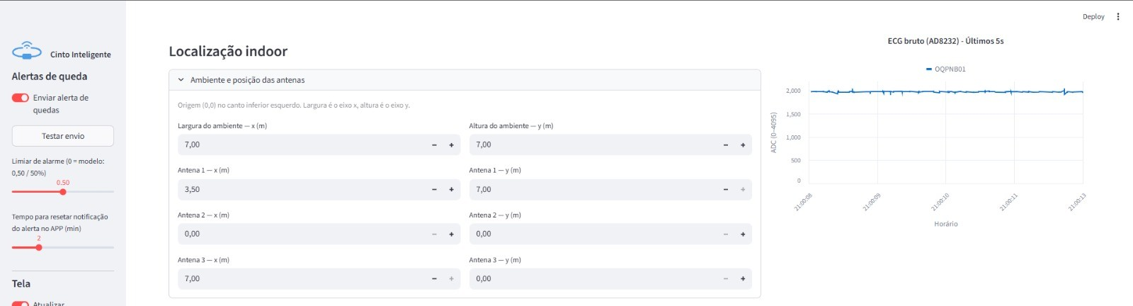
docs/IMAGENS/prints/config_localizacao_ECG_.jpeg
