KaykyCrespo/cinto-inteligente-deteccao-quedas/docs/IMAGENS/prints/mapa_exportacao_dados.jpeg

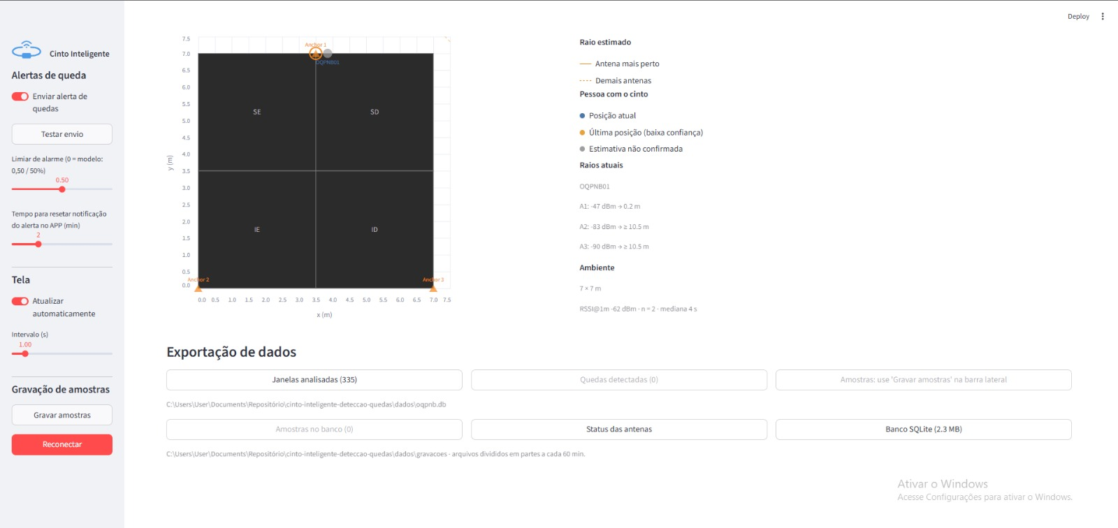
docs/IMAGENS/prints/mapa_exportacao_dados.jpeg
