KaykyCrespo/cinto-inteligente-deteccao-quedas/docs/IMAGENS/prints/monitoramento.png

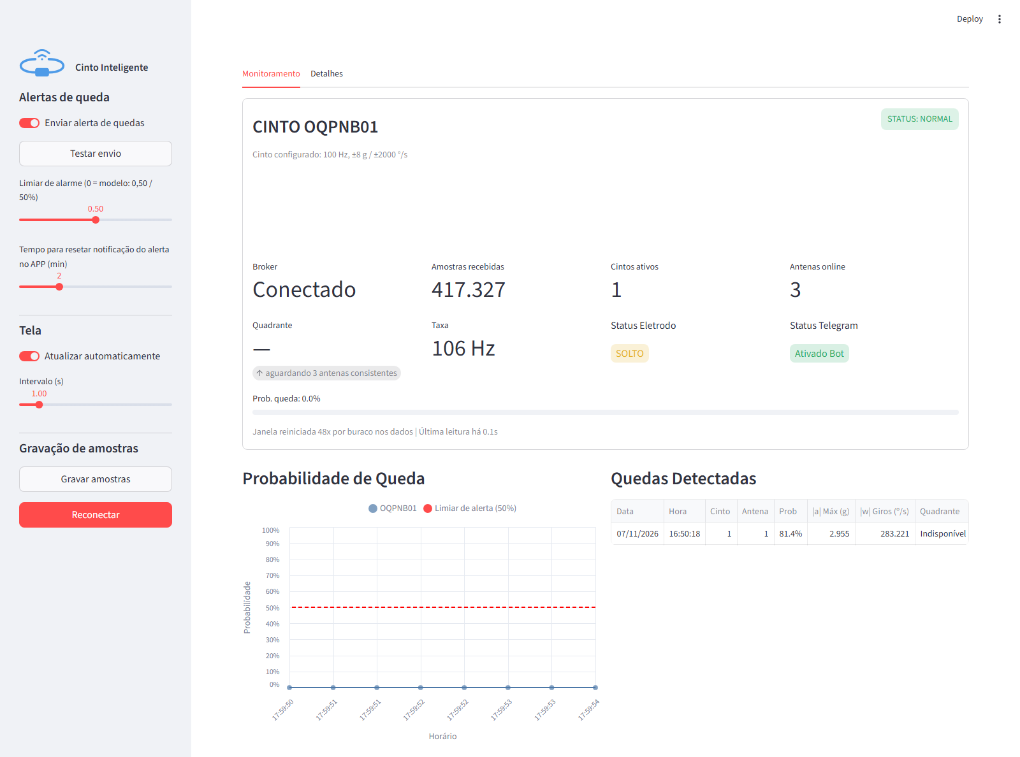
docs/IMAGENS/prints/monitoramento.png
