KaykyCrespo/cinto-inteligente-deteccao-quedas/docs/IMAGENS/prints/tabela RSSI e historico de quedas.jpeg

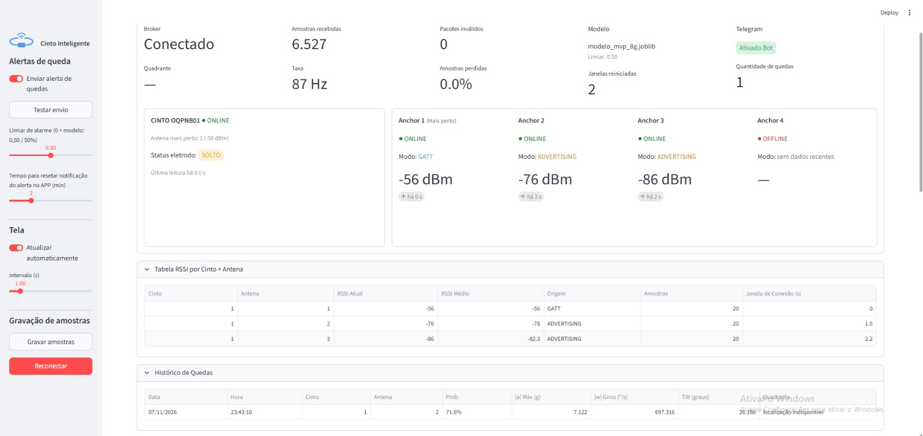
docs/IMAGENS/prints/tabela RSSI e historico de quedas.jpeg
