KaykyCrespo/cinto-inteligente-deteccao-quedas/modelos/resultado_treino_mvp_8g.txt

Configuração: 100 Hz, ±8 g, ±2000 °/s
Lendo SisFall...
Janelas: 122572  (quedas 28768, atividades 93804)  voluntários: 38

Validação cruzada por voluntário (5 folds), limiar 0.5:
  fold 1: sensibilidade 0.968  especificidade 0.963
  fold 2: sensibilidade 0.981  especificidade 0.948
  fold 3: sensibilidade 1.000  especificidade 0.974
  fold 4: sensibilidade 1.000  especificidade 0.942
  fold 5: sensibilidade 0.995  especificidade 0.936

Por ensaio (queda detectada em algum momento do registro):
  Sensibilidade 0.988  (1777/1798 quedas detectadas)
  Especificidade 0.953  (128 alarmes falsos em 2707 atividades)

Efeito do limiar (escolha conforme o custo de um alarme falso x uma queda perdida):
  limiar 0.3: sensibilidade 0.992  especificidade 0.919
  limiar 0.4: sensibilidade 0.990  especificidade 0.940
  limiar 0.5: sensibilidade 0.988  especificidade 0.953
  limiar 0.6: sensibilidade 0.984  especificidade 0.965
  limiar 0.7: sensibilidade 0.979  especificidade 0.978
  limiar 0.8: sensibilidade 0.970  especificidade 0.986

Por atividade (limiar 0.5):
  D01: 0/38 alarmes falsos
  D02: 0/38 alarmes falsos
  D03: 0/38 alarmes falsos
  D04: 0/36 alarmes falsos
  D05: 0/190 alarmes falsos
  D06: 15/118 alarmes falsos
  D07: 0/190 alarmes falsos
  D08: 5/190 alarmes falsos
  D09: 0/185 alarmes falsos
  D10: 12/185 alarmes falsos
  D11: 53/190 alarmes falsos
  D12: 0/190 alarmes falsos
  D13: 1/120 alarmes falsos
  D14: 14/190 alarmes falsos
  D15: 0/190 alarmes falsos
  D16: 0/190 alarmes falsos
  D17: 0/189 alarmes falsos
  D18: 14/120 alarmes falsos
  D19: 14/120 alarmes falsos
  F01: 118/119 detectadas
  F02: 120/120 detectadas
  F03: 120/120 detectadas
  F04: 120/120 detectadas
  F05: 120/120 detectadas
  F06: 120/120 detectadas
  F07: 119/120 detectadas
  F08: 120/120 detectadas
  F09: 119/120 detectadas
  F10: 115/119 detectadas
  F11: 120/120 detectadas
  F12: 120/120 detectadas
  F13: 112/120 detectadas
  F14: 115/120 detectadas
  F15: 119/120 detectadas

Importância das features: tilt=0.33, gstd=0.18, amax=0.13, gmax=0.12, astd=0.08, jerk=0.07, post_std=0.04, amin=0.04

Modelo salvo em modelo_mvp_8g.joblib
