KaykyCrespo/cinto-inteligente-deteccao-quedas/dados/testes/andando/1 min andando anchor 3 17-21 a 170-22.csv

timestamp | origem | id_cinto | id_antena | rssi | seq | ax | ay | az | gx | gy | gz | eletrodos_conectados | sinal_ad8232
2026-11-09T15:21:02.286 | gatt | 1 | 1 | -75 |  | 1620 | 262 | -3824 | -148 | 78 | -787 | 1 | 1966
2026-11-09T15:21:02.292 | gatt | 1 | 1 | -75 |  | 1561 | 257 | -3790 | -142 | 71 | -835 | 1 | 1965
2026-11-09T15:21:02.293 | gatt | 1 | 1 | -75 |  | 1613 | 212 | -3786 | -123 | 72 | -885 | 1 | 1965
2026-11-09T15:21:02.293 | gatt | 1 | 1 | -75 |  | 1542 | 236 | -3674 | -99 | 63 | -934 | 1 | 1966
2026-11-09T15:21:02.293 | gatt | 1 | 1 | -75 |  | 1509 | 270 | -3620 | -78 | 58 | -970 | 1 | 1964
2026-11-09T15:21:02.397 | gatt | 1 | 1 | -75 |  | 1520 | 287 | -3545 | -71 | 48 | -998 | 1 | 2026
2026-11-09T15:21:02.398 | gatt | 1 | 1 | -75 |  | 1489 | 308 | -3391 | -67 | 14 | -1030 | 1 | 1967
2026-11-09T15:21:02.398 | gatt | 1 | 1 | -75 |  | 1495 | 280 | -3361 | -51 | -31 | -1070 | 1 | 1965
2026-11-09T15:21:02.400 | gatt | 1 | 1 | -75 |  | 1559 | 276 | -3356 | -35 | -65 | -1111 | 1 | 2010
2026-11-09T15:21:02.400 | gatt | 1 | 1 | -75 |  | 1579 | 306 | -3412 | -36 | -77 | -1141 | 1 | 1964
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
