KaykyCrespo/cinto-inteligente-deteccao-quedas/dados/testes/andando/1min andando anchor 1 15-14 a 15-15.csv

timestamp | origem | id_cinto | id_antena | rssi | seq | ax | ay | az | gx | gy | gz | eletrodos_conectados | sinal_ad8232
2026-11-09T15:13:22.425 | gatt | 1 | 1 | -75 |  | 1993 | -567 | -3553 | -2 | 3 | -37 | 1 | 1965
2026-11-09T15:13:22.448 | gatt | 1 | 1 | -75 |  | 2001 | -566 | -3532 | -8 | 3 | -36 | 1 | 1965
2026-11-09T15:13:22.683 | gatt | 1 | 1 | -75 |  | 2004 | -553 | -3575 | -9 | 1 | -32 | 1 | 1964
2026-11-09T15:13:22.690 | gatt | 1 | 1 | -75 |  | 2015 | -595 | -3583 | -3 | 5 | -34 | 1 | 1966
2026-11-09T15:13:22.699 | gatt | 1 | 1 | -75 |  | 1985 | -544 | -3532 | -10 | -1 | -35 | 1 | 1964
2026-11-09T15:13:22.700 | gatt | 1 | 1 | -75 |  | 1975 | -546 | -3555 | -8 | -2 | -27 | 1 | 1965
2026-11-09T15:13:22.701 | gatt | 1 | 1 | -75 |  | 2010 | -556 | -3519 | -11 | -2 | -28 | 1 | 1964
2026-11-09T15:13:22.701 | gatt | 1 | 1 | -75 |  | 1969 | -528 | -3535 | -7 | 2 | -33 | 1 | 1964
2026-11-09T15:13:22.703 | gatt | 1 | 1 | -75 |  | 1979 | -519 | -3520 | -8 | -1 | -29 | 1 | 1964
2026-11-09T15:13:22.707 | gatt | 1 | 1 | -75 |  | 1994 | -551 | -3561 | -6 | 6 | -30 | 1 | 1966
2026-11-09T15:13:22.708 | gatt | 1 | 1 | -75 |  | 1998 | -566 | -3558 | -7 | 1 | -37 | 1 | 1965
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
