KaykyCrespo/cinto-inteligente-deteccao-quedas/dados/testes/andando/1min andando anchor 2 17-17 a 17-18.csv

timestamp | origem | id_cinto | id_antena | rssi | seq | ax | ay | az | gx | gy | gz | eletrodos_conectados | sinal_ad8232
2026-11-09T15:18:25.245 | gatt | 1 | 1 | -84 |  | -876 | -479 | -4083 | -121 | 229 | 179 | 1 | 1974
2026-11-09T15:18:25.248 | gatt | 1 | 1 | -84 |  | -813 | -469 | -3984 | -84 | 233 | 133 | 1 | 1965
2026-11-09T15:18:25.249 | gatt | 1 | 1 | -84 |  | -811 | -399 | -3908 | -58 | 232 | 92 | 1 | 1964
2026-11-09T15:18:25.250 | gatt | 1 | 1 | -84 |  | -793 | -348 | -3812 | -41 | 223 | 52 | 1 | 1963
2026-11-09T15:18:25.251 | gatt | 1 | 1 | -84 |  | -741 | -289 | -3782 | -36 | 218 | 13 | 1 | 1964
2026-11-09T15:18:25.253 | gatt | 1 | 1 | -84 |  | -681 | -176 | -3737 | -35 | 215 | -28 | 1 | 1983
2026-11-09T15:18:25.253 | gatt | 1 | 1 | -84 |  | -667 | -80 | -3729 | -48 | 207 | -56 | 1 | 1964
2026-11-09T15:18:25.255 | gatt | 1 | 1 | -84 |  | -654 | 0 | -3705 | -63 | 199 | -67 | 1 | 1965
2026-11-09T15:18:25.257 | gatt | 1 | 1 | -74 |  | -618 | 10 | -3634 | -72 | 195 | -71 | 1 | 1968
2026-11-09T15:18:25.261 | gatt | 1 | 1 | -74 |  | -628 | 45 | -3594 | -77 | 204 | -67 | 1 | 1977
2026-11-09T15:18:25.263 | gatt | 1 | 1 | -74 |  | -519 | 62 | -3545 | -72 | 223 | -51 | 1 | 1965
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
