KaykyCrespo/cinto-inteligente-deteccao-quedas/dados/testes/deitar/deitando 15-41.csv

timestamp | origem | id_cinto | id_antena | rssi | seq | ax | ay | az | gx | gy | gz | eletrodos_conectados | sinal_ad8232
2026-11-09T15:41:43.801 | gatt | 1 | 1 | -76 |  | 3359 | -356 | -2494 | -12 | 2 | -18 | 1 | 1962
2026-11-09T15:41:43.811 | gatt | 1 | 1 | -76 |  | 3387 | -306 | -2489 | -13 | 2 | -21 | 1 | 1962
2026-11-09T15:41:43.821 | gatt | 1 | 1 | -76 |  | 3356 | -335 | -2483 | -11 | 2 | -29 | 1 | 1963
2026-11-09T15:41:43.827 | gatt | 1 | 1 | -76 |  | 3379 | -341 | -2469 | -13 | -4 | -25 | 1 | 1962
2026-11-09T15:41:43.839 | gatt | 1 | 1 | -76 |  | 3380 | -322 | -2458 | -11 | -7 | -29 | 1 | 1963
2026-11-09T15:41:43.866 | gatt | 1 | 1 | -76 |  | 3394 | -328 | -2456 | -14 | -11 | -28 | 1 | 1965
2026-11-09T15:41:43.870 | gatt | 1 | 1 | -76 |  | 3426 | -312 | -2521 | -9 | -8 | -26 | 1 | 1991
2026-11-09T15:41:43.872 | gatt | 1 | 1 | -76 |  | 3425 | -348 | -2518 | -13 | -4 | -24 | 1 | 1962
2026-11-09T15:41:43.874 | gatt | 1 | 1 | -76 |  | 3409 | -335 | -2505 | -8 | 5 | -23 | 1 | 1965
2026-11-09T15:41:43.875 | gatt | 1 | 1 | -76 |  | 3403 | -353 | -2525 | -9 | 12 | -22 | 1 | 1961
2026-11-09T15:41:43.878 | gatt | 1 | 1 | -76 |  | 3368 | -355 | -2482 | -11 | 12 | -26 | 1 | 1962
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
