KaykyCrespo/cinto-inteligente-deteccao-quedas/dados/testes/quedas/quedas anchor 1 15-46.csv

timestamp | origem | id_cinto | id_antena | rssi | seq | ax | ay | az | gx | gy | gz | eletrodos_conectados | sinal_ad8232
2026-11-09T15:46:40.983 | gatt | 1 | 1 | -86 |  | 1559 | -223 | -3776 | -7 | 13 | -94 | 1 | 1962
2026-11-09T15:46:40.991 | gatt | 1 | 1 | -86 |  | 1540 | -215 | -3782 | -10 | 22 | -89 | 1 | 1960
2026-11-09T15:46:41.001 | gatt | 1 | 1 | -86 |  | 1556 | -241 | -3779 | -16 | 29 | -82 | 1 | 1961
2026-11-09T15:46:41.004 | gatt | 1 | 1 | -86 |  | 1534 | -206 | -3757 | -23 | 29 | -74 | 1 | 1962
2026-11-09T15:46:41.009 | gatt | 1 | 1 | -86 |  | 1548 | -229 | -3731 | -25 | 32 | -67 | 1 | 1962
2026-11-09T15:46:41.013 | gatt | 1 | 1 | -86 |  | 1572 | -258 | -3783 | -27 | 37 | -56 | 1 | 1962
2026-11-09T15:46:41.017 | gatt | 1 | 1 | -86 |  | 1598 | -222 | -3774 | -29 | 53 | -44 | 1 | 1962
2026-11-09T15:46:41.019 | gatt | 1 | 1 | -86 |  | 1613 | -194 | -3841 | -37 | 74 | -31 | 1 | 1962
2026-11-09T15:46:41.027 | gatt | 1 | 1 | -86 |  | 1628 | -168 | -3736 | -40 | 87 | -15 | 1 | 1947
2026-11-09T15:46:41.028 | gatt | 1 | 1 | -86 |  | 1631 | -172 | -3811 | -41 | 102 | -3 | 1 | 1903
2026-11-09T15:46:41.030 | gatt | 1 | 1 | -86 |  | 1639 | -139 | -3753 | -50 | 110 | 11 | 1 | 1962
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
