KaykyCrespo/cinto-inteligente-deteccao-quedas/dados/testes/quedas/quedas anchor 2 16-00.csv

timestamp | origem | id_cinto | id_antena | rssi | seq | ax | ay | az | gx | gy | gz | eletrodos_conectados | sinal_ad8232
2026-11-09T15:58:16.116 | gatt | 1 | 3 | -81 |  | 3568 | -658 | -2127 | -28 | -82 | -12 | 1 | 1963
2026-11-09T15:58:16.119 | gatt | 1 | 3 | -81 |  | 3569 | -671 | -2193 | -25 | -86 | -16 | 1 | 1966
2026-11-09T15:58:16.119 | gatt | 1 | 3 | -81 |  | 3567 | -676 | -2190 | -20 | -92 | -18 | 1 | 1962
2026-11-09T15:58:16.119 | gatt | 1 | 3 | -81 |  | 3579 | -710 | -2195 | -21 | -97 | -21 | 1 | 1976
2026-11-09T15:58:16.121 | gatt | 1 | 3 | -81 |  | 3591 | -716 | -2152 | -18 | -97 | -19 | 1 | 1960
2026-11-09T15:58:16.121 | gatt | 1 | 3 | -81 |  | 3609 | -707 | -2200 | -19 | -93 | -25 | 1 | 1962
2026-11-09T15:58:16.122 | gatt | 1 | 3 | -77 |  | 3588 | -721 | -2172 | -17 | -89 | -23 | 1 | 1963
2026-11-09T15:58:16.122 | gatt | 1 | 3 | -77 |  | 3559 | -725 | -2171 | -22 | -86 | -24 | 1 | 1962
2026-11-09T15:58:16.323 | gatt | 1 | 3 | -77 |  | 3559 | -720 | -2179 | -18 | -82 | -25 | 1 | 1962
2026-11-09T15:58:16.325 | gatt | 1 | 3 | -77 |  | 3555 | -707 | -2205 | -16 | -82 | -30 | 1 | 1964
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
