KaykyCrespo/cinto-inteligente-deteccao-quedas/dados/testes/quedas/quedas anchor 3 16-03.csv

timestamp | origem | id_cinto | id_antena | rssi | seq | ax | ay | az | gx | gy | gz | eletrodos_conectados | sinal_ad8232
2026-11-09T16:02:14.512 | gatt | 1 | 3 | -88 |  | 2708 | -264 | -3169 | -1 | 30 | -32 | 1 | 1962
2026-11-09T16:02:14.512 | gatt | 1 | 3 | -88 |  | 2712 | -249 | -3180 | -1 | 30 | -29 | 1 | 1962
2026-11-09T16:02:14.513 | gatt | 1 | 3 | -84 |  | 2716 | -242 | -3157 | -3 | 34 | -30 | 1 | 1963
2026-11-09T16:02:14.518 | gatt | 1 | 3 | -84 |  | 2702 | -262 | -3185 | -7 | 34 | -26 | 1 | 1962
2026-11-09T16:02:14.519 | gatt | 1 | 3 | -84 |  | 2696 | -245 | -3135 | -6 | 36 | -28 | 1 | 1962
2026-11-09T16:02:14.521 | gatt | 1 | 3 | -84 |  | 2707 | -239 | -3156 | -3 | 33 | -28 | 1 | 1962
2026-11-09T16:02:14.522 | gatt | 1 | 3 | -84 |  | 2701 | -236 | -3138 | -9 | 34 | -31 | 1 | 1961
2026-11-09T16:02:14.523 | gatt | 1 | 3 | -84 |  | 2683 | -232 | -3119 | -2 | 37 | -32 | 1 | 1964
2026-11-09T16:02:14.524 | gatt | 1 | 3 | -84 |  | 2706 | -250 | -3127 | -5 | 33 | -31 | 1 | 1962
2026-11-09T16:02:14.525 | gatt | 1 | 3 | -84 |  | 2688 | -262 | -3152 | -3 | 29 | -32 | 1 | 1962
2026-11-09T16:02:14.526 | gatt | 1 | 3 | -84 |  | 2684 | -254 | -3085 | -4 | 24 | -29 | 1 | 1962
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
