KaykyCrespo/cinto-inteligente-deteccao-quedas/dados/testes/sentar/sentando anchor 2 15-31.csv

timestamp | origem | id_cinto | id_antena | rssi | seq | ax | ay | az | gx | gy | gz | eletrodos_conectados | sinal_ad8232
2026-11-09T15:31:19.410 | gatt | 1 | 1 | -78 |  | 1501 | -201 | -3300 | 84 | 24 | -136 | 1 | 1962
2026-11-09T15:31:19.414 | gatt | 1 | 1 | -78 |  | 1742 | -138 | -3265 | 46 | 30 | -67 | 1 | 1964
2026-11-09T15:31:19.414 | gatt | 1 | 1 | -78 |  | 1678 | -21 | -3298 | -17 | -4 | -15 | 1 | 1965
2026-11-09T15:31:19.415 | gatt | 1 | 1 | -78 |  | 1792 | -41 | -3444 | -62 | -39 | 22 | 1 | 1981
2026-11-09T15:31:19.416 | gatt | 1 | 1 | -78 |  | 1887 | -171 | -3549 | -94 | -54 | 61 | 1 | 1974
2026-11-09T15:31:19.416 | gatt | 1 | 1 | -78 |  | 1859 | -181 | -3685 | -133 | -36 | 117 | 1 | 1961
2026-11-09T15:31:19.416 | gatt | 1 | 1 | -72 |  | 1924 | -278 | -3785 | -170 | -3 | 173 | 1 | 1961
2026-11-09T15:31:19.416 | gatt | 1 | 1 | -72 |  | 1914 | -300 | -3780 | -224 | 32 | 234 | 1 | 1962
2026-11-09T15:31:19.417 | gatt | 1 | 1 | -72 |  | 1805 | -334 | -3786 | -269 | 36 | 294 | 1 | 1964
2026-11-09T15:31:19.417 | gatt | 1 | 1 | -72 |  | 1692 | -372 | -3755 | -304 | 25 | 342 | 1 | 1964
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
