KaykyCrespo/cinto-inteligente-deteccao-quedas/dados/testes/sentar/sentando anchor 3 15-34.csv

timestamp | origem | id_cinto | id_antena | rssi | seq | ax | ay | az | gx | gy | gz | eletrodos_conectados | sinal_ad8232
2026-11-09T15:34:39.432 | gatt | 1 | 1 | -70 |  | 2417 | 771 | -2775 | 328 | -687 | 381 | 1 | 1963
2026-11-09T15:34:39.560 | gatt | 1 | 1 | -72 |  | 2519 | 680 | -2848 | 329 | -735 | 356 | 1 | 1962
2026-11-09T15:34:39.566 | gatt | 1 | 1 | -72 |  | 2449 | 581 | -2929 | 322 | -762 | 346 | 1 | 1962
2026-11-09T15:34:39.566 | gatt | 1 | 1 | -72 |  | 2688 | 436 | -3172 | 308 | -771 | 346 | 1 | 1963
2026-11-09T15:34:39.567 | advertising | 1 | 2 | -87
2026-11-09T15:34:39.567 | advertising | 1 | 3 | -93
2026-11-09T15:34:39.567 | gatt | 1 | 1 | -72 |  | 2630 | 386 | -3252 | 282 | -769 | 365 | 1 | 1961
2026-11-09T15:34:39.567 | gatt | 1 | 1 | -72 |  | 2802 | 193 | -3449 | 254 | -713 | 357 | 1 | 1962
2026-11-09T15:34:39.567 | gatt | 1 | 1 | -72 |  | 2666 | 23 | -3488 | 247 | -678 | 344 | 1 | 1965
2026-11-09T15:34:39.567 | gatt | 1 | 1 | -72 |  | 2581 | -10 | -3551 | 249 | -642 | 334 | 1 | 1964
2026-11-09T15:34:39.567 | gatt | 1 | 1 | -72 |  | 2514 | 41 | -3515 | 253 | -614 | 343 | 1 | 1964
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
