KaykyCrespo/cinto-inteligente-deteccao-quedas/dados/testes/sentar/sentando na anchor 1 15-29.csv

timestamp | origem | id_cinto | id_antena | rssi | seq | ax | ay | az | gx | gy | gz | eletrodos_conectados | sinal_ad8232
2026-11-09T15:28:41.625 | gatt | 1 | 1 | -80 |  | 2885 | -526 | -2978 | -5 | 8 | -29 | 1 | 1993
2026-11-09T15:28:41.628 | gatt | 1 | 1 | -80 |  | 2867 | -539 | -2953 | -3 | 7 | -28 | 1 | 1976
2026-11-09T15:28:41.633 | gatt | 1 | 1 | -80 |  | 2884 | -548 | -2978 | -6 | 5 | -30 | 1 | 1964
2026-11-09T15:28:41.643 | gatt | 1 | 1 | -80 |  | 2882 | -535 | -2968 | -11 | 5 | -29 | 1 | 1965
2026-11-09T15:28:41.648 | gatt | 1 | 1 | -82 |  | 2869 | -558 | -2984 | -9 | 1 | -31 | 1 | 1965
2026-11-09T15:28:41.664 | gatt | 1 | 1 | -82 |  | 2864 | -553 | -2989 | -8 | 4 | -35 | 1 | 1964
2026-11-09T15:28:41.664 | gatt | 1 | 1 | -82 |  | 2873 | -553 | -2996 | -7 | 1 | -34 | 1 | 1965
2026-11-09T15:28:41.667 | gatt | 1 | 1 | -82 |  | 2897 | -544 | -3000 | -6 | 1 | -35 | 1 | 1967
2026-11-09T15:28:41.668 | gatt | 1 | 1 | -82 |  | 2890 | -533 | -3004 | -7 | 1 | -33 | 1 | 1965
2026-11-09T15:28:41.675 | gatt | 1 | 1 | -82 |  | 2874 | -549 | -3056 | -9 | 0 | -32 | 1 | 1964
2026-11-09T15:28:41.687 | gatt | 1 | 1 | -82 |  | 2907 | -526 | -3005 | -7 | 7 | -30 | 1 | 1966
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
