KaykyCrespo/cinto-inteligente-deteccao-quedas/dados/ensaios_rssi/Teste 1m GATT na Anchor1.csv

timestamp | origem | id_cinto | id_antena | rssi | seq | ax | ay | az | gx | gy | gz | eletrodos_conectados | sinal_ad8232
2026-11-04T20:23:53.388 | gatt | 1 | 1 | -34 |  | 4217 | -221 | 1242 | -5 | -21 | -40 | 0 | 1966
2026-11-04T20:23:53.388 | gatt | 1 | 1 | -34 |  | 4258 | -167 | 1225 | -5 | -24 | -46 | 0 | 1965
2026-11-04T20:23:53.389 | gatt | 1 | 1 | -34 |  | 4235 | -178 | 1200 | -8 | -5 | -34 | 0 | 1967
2026-11-04T20:23:53.391 | gatt | 1 | 1 | -34 |  | 4240 | -204 | 1230 | -12 | 5 | -16 | 0 | 1967
2026-11-04T20:23:53.392 | gatt | 1 | 1 | -34 |  | 4269 | -229 | 1261 | -12 | 8 | -12 | 0 | 1965
2026-11-04T20:23:53.393 | gatt | 1 | 1 | -34 |  | 4269 | -261 | 1226 | -10 | -7 | -28 | 0 | 1965
2026-11-04T20:23:53.394 | gatt | 1 | 1 | -34 |  | 4307 | -289 | 1204 | -9 | -10 | -39 | 0 | 1965
2026-11-04T20:23:53.396 | gatt | 1 | 1 | -34 |  | 4317 | -287 | 1282 | -5 | 4 | -41 | 0 | 1965
2026-11-04T20:23:53.396 | gatt | 1 | 1 | -34 |  | 4301 | -282 | 1231 | -7 | 9 | -41 | 0 | 1965
2026-11-04T20:23:53.396 | gatt | 1 | 1 | -32 |  | 4237 | -268 | 1258 | -2 | -3 | -43 | 0 | 1945
2026-11-04T20:23:53.398 | gatt | 1 | 1 | -32 |  | 4201 | -222 | 1226 | 0 | -14 | -44 | 0 | 1966
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
