KaykyCrespo/cinto-inteligente-deteccao-quedas/dados/ensaios_rssi/Teste 1m GATT na Anchor2.csv

timestamp | origem | id_cinto | id_antena | rssi | seq | ax | ay | az | gx | gy | gz | eletrodos_conectados | sinal_ad8232
2026-11-04T20:34:25.672 | gatt | 1 | 2 | -83 |  | 4368 | -294 | 239 | -19 | 1 | 7 | 0 | 1949
2026-11-04T20:34:25.673 | gatt | 1 | 2 | -83 |  | 4349 | -264 | 213 | -22 | -19 | 14 | 0 | 1944
2026-11-04T20:34:25.676 | gatt | 1 | 2 | -83 |  | 4371 | -308 | 193 | -24 | -28 | 17 | 0 | 1948
2026-11-04T20:34:25.676 | gatt | 1 | 2 | -83 |  | 4394 | -304 | 167 | -25 | -25 | 16 | 0 | 1950
2026-11-04T20:34:25.677 | gatt | 1 | 2 | -83 |  | 4432 | -305 | 188 | -26 | -7 | 10 | 0 | 1949
2026-11-04T20:34:25.677 | gatt | 1 | 2 | -83 |  | 4440 | -334 | 161 | -28 | 10 | 4 | 0 | 1944
2026-11-04T20:34:25.677 | gatt | 1 | 2 | -87 |  | 4381 | -322 | 145 | -27 | 20 | 3 | 0 | 1949
2026-11-04T20:34:25.680 | gatt | 1 | 2 | -87 |  | 4386 | -300 | 195 | -22 | 23 | 3 | 0 | 1950
2026-11-04T20:34:25.680 | gatt | 1 | 2 | -87 |  | 4362 | -321 | 195 | -23 | 12 | 5 | 0 | 1950
2026-11-04T20:34:25.680 | gatt | 1 | 2 | -87 |  | 4333 | -316 | 193 | -24 | -2 | 14 | 0 | 1949
2026-11-04T20:34:25.682 | gatt | 1 | 2 | -87 |  | 4337 | -341 | 225 | -25 | -20 | 18 | 0 | 1949
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
