KaykyCrespo/cinto-inteligente-deteccao-quedas/dados/ensaios_rssi/Teste 1m GATT na Anchor3.csv

timestamp | origem | id_cinto | id_antena | rssi | seq | ax | ay | az | gx | gy | gz | eletrodos_conectados | sinal_ad8232
2026-11-04T20:40:36.030 | anuncio | 1 | 1 | -46
2026-11-04T20:40:36.030 | anuncio | 1 | 2 | -80
2026-11-04T20:40:36.037 | anuncio | 1 | 1 | -48
2026-11-04T20:40:36.046 | anuncio | 1 | 2 | -77
2026-11-04T20:40:36.147 | anuncio | 1 | 1 | -45
2026-11-04T20:40:36.287 | anuncio | 1 | 2 | -91
2026-11-04T20:40:36.302 | anuncio | 1 | 1 | -50
2026-11-04T20:40:36.345 | anuncio | 1 | 2 | -92
2026-11-04T20:40:36.477 | anuncio | 1 | 1 | -56
2026-11-04T20:40:36.546 | anuncio | 1 | 2 | -85
2026-11-04T20:40:36.554 | anuncio | 1 | 1 | -65
2026-11-04T20:40:36.661 | anuncio | 1 | 2 | -89
2026-11-04T20:40:39.515 | anuncio | 1 | 1 | -79
2026-11-04T20:40:39.830 | anuncio | 1 | 2 | -95
2026-11-04T20:40:39.830 | anuncio | 1 | 1 | -68
2026-11-04T20:40:39.938 | anuncio | 1 | 2 | -92
2026-11-04T20:40:39.939 | anuncio | 1 | 1 | -67
2026-11-04T20:40:40.128 | anuncio | 1 | 2 | -92
2026-11-04T20:40:40.129 | anuncio | 1 | 1 | -73
2026-11-04T20:40:40.134 | anuncio | 1 | 1 | -69
2026-11-04T20:40:40.233 | anuncio | 1 | 2 | -85
2026-11-04T20:40:40.238 | anuncio | 1 | 1 | -72
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
