KaykyCrespo/cinto-inteligente-deteccao-quedas/dados/ensaios_rssi/teste 1m.csv

timestamp | origem | id_cinto | id_antena | rssi | seq | ax | ay | az | gx | gy | gz | eletrodos_conectados | sinal_ad8232
2026-11-11T17:24:09.120 | gatt | 1 | 1 | -84 |  | -1340 | -23 | 3939 | 0 | 1 | -40 | 0 | 1978
2026-11-11T17:24:09.120 | gatt | 1 | 1 | -84 |  | -1351 | -50 | 3961 | 0 | 6 | -40 | 0 | 1980
2026-11-11T17:24:09.120 | gatt | 1 | 1 | -84 |  | -1336 | -60 | 3991 | -2 | 3 | -40 | 0 | 1980
2026-11-11T17:24:09.121 | gatt | 1 | 1 | -84 |  | -1337 | -74 | 3999 | 0 | 3 | -41 | 0 | 1979
2026-11-11T17:24:09.121 | gatt | 1 | 1 | -84 |  | -1319 | -32 | 3991 | -1 | 3 | -39 | 0 | 1979
2026-11-11T17:24:09.121 | gatt | 1 | 1 | -84 |  | -1291 | -39 | 4009 | -4 | -2 | -39 | 0 | 1981
2026-11-11T17:24:09.121 | gatt | 1 | 1 | -84 |  | -1318 | -24 | 3910 | -2 | -3 | -36 | 0 | 1979
2026-11-11T17:24:09.121 | gatt | 1 | 1 | -84 |  | -1333 | -30 | 3969 | -1 | 1 | -35 | 0 | 1980
2026-11-11T17:24:09.121 | gatt | 1 | 1 | -84 |  | -1337 | -51 | 3969 | 2 | -2 | -41 | 0 | 1979
2026-11-11T17:24:09.121 | gatt | 1 | 1 | -84 |  | -1338 | -8 | 3963 | 1 | -1 | -37 | 0 | 1979
2026-11-11T17:24:09.228 | gatt | 1 | 1 | -84 |  | -1337 | -48 | 3975 | -1 | 2 | -35 | 0 | 1980
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
