KaykyCrespo/cinto-inteligente-deteccao-quedas/dados/ensaios_rssi/teste 2m.csv

timestamp | origem | id_cinto | id_antena | rssi | seq | ax | ay | az | gx | gy | gz | eletrodos_conectados | sinal_ad8232
2026-11-11T17:30:20.907 | gatt | 1 | 1 | -78 |  | -1618 | 12 | 3787 | -8 | -4 | -28 | 0 | 1976
2026-11-11T17:30:20.910 | gatt | 1 | 1 | -78 |  | -1602 | 19 | 3812 | -10 | 0 | -31 | 0 | 1977
2026-11-11T17:30:20.910 | gatt | 1 | 1 | -78 |  | -1623 | 20 | 3777 | -8 | 1 | -32 | 0 | 1975
2026-11-11T17:30:20.910 | gatt | 1 | 1 | -78 |  | -1668 | 6 | 3865 | -11 | 0 | -32 | 0 | 1976
2026-11-11T17:30:20.910 | gatt | 1 | 1 | -78 |  | -1676 | 53 | 3829 | -12 | 0 | -32 | 0 | 1975
2026-11-11T17:30:20.910 | gatt | 1 | 1 | -78 |  | -1642 | 37 | 3849 | -14 | -8 | -32 | 0 | 1967
2026-11-11T17:30:20.910 | gatt | 1 | 1 | -78 |  | -1671 | 56 | 3875 | -17 | -19 | -26 | 0 | 1975
2026-11-11T17:30:20.910 | gatt | 1 | 1 | -78 |  | -1644 | 86 | 3851 | -16 | -17 | -24 | 0 | 1980
2026-11-11T17:30:20.910 | gatt | 1 | 1 | -78 |  | -1625 | 66 | 3788 | -19 | -16 | -20 | 0 | 1967
2026-11-11T17:30:20.910 | gatt | 1 | 1 | -78 |  | -1628 | 70 | 3829 | -18 | -10 | -17 | 0 | 1974
2026-11-11T17:30:20.911 | gatt | 1 | 1 | -78 |  | -1635 | 45 | 3840 | -21 | -2 | -15 | 0 | 1977
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
