KaykyCrespo/cinto-inteligente-deteccao-quedas/dados/ensaios_rssi/teste 3m.csv

timestamp | origem | id_cinto | id_antena | rssi | seq | ax | ay | az | gx | gy | gz | eletrodos_conectados | sinal_ad8232
2026-11-11T17:35:40.037 | gatt | 1 | 1 | -91 |  | -1711 | 72 | 3828 | -14 | -1 | -23 | 0 | 1975
2026-11-11T17:35:40.038 | gatt | 1 | 1 | -91 |  | -1739 | 98 | 3787 | -14 | 0 | -18 | 0 | 1967
2026-11-11T17:35:40.038 | advertising | 1 | 3 | -78
2026-11-11T17:35:40.038 | gatt | 1 | 1 | -83 |  | -1682 | 113 | 3787 | -16 | -5 | -17 | 0 | 1968
2026-11-11T17:35:40.038 | gatt | 1 | 1 | -83 |  | -1702 | 148 | 3813 | -15 | 1 | -18 | 0 | 1976
2026-11-11T17:35:40.038 | gatt | 1 | 1 | -83 |  | -1704 | 153 | 3777 | -15 | -2 | -16 | 0 | 1965
2026-11-11T17:35:40.038 | gatt | 1 | 1 | -83 |  | -1699 | 165 | 3804 | -14 | 4 | -18 | 0 | 1966
2026-11-11T17:35:40.039 | gatt | 1 | 1 | -83 |  | -1724 | 141 | 3842 | -14 | 10 | -19 | 0 | 1963
2026-11-11T17:35:40.039 | gatt | 1 | 1 | -83 |  | -1709 | 141 | 3808 | -14 | 2 | -16 | 0 | 1966
2026-11-11T17:35:40.039 | gatt | 1 | 1 | -83 |  | -1723 | 111 | 3767 | -14 | 0 | -15 | 0 | 1952
2026-11-11T17:35:40.039 | gatt | 1 | 1 | -83 |  | -1702 | 117 | 3769 | -17 | -5 | -21 | 0 | 1965
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
