KaykyCrespo/cinto-inteligente-deteccao-quedas/dados/SISFALL/SisFall_dataset/Supplementary.pdf

# Supplementary Material: SisFall, A Fall and Movement Dataset

## A. Sucerquia, J.D. Lopez, J.F. Vargas-Bonilla ´ SISTEMIC, Facultad de Ingenier´ıa, Universidad de Antiquia UDEA Calle 70 No. 52-21, Tel.: +57-4-2198561, Medell´ın, Colombia

josedavid@udea.edu.co

I. RESULTS
In this document we include tables with results of all 14 features tested (listed in Table IV of the paper). Table S1 shows the effect of filtering as preprocessing stage (paper Fig. 3) after a 10-fold cross-validation with all subjects (validation accuracy, mean and standard deviation).

TABLE S1
ACCURACY OBTAINED IN VALIDATION (451 TRIALS) AFTER A 10-FOLD CROSS-VALIDATION WITHOUT- (RAW DATA) AND WITH PREPROCESSING (FILTERED).
Feature | Raw data | Filtered
C1 C2 C3 C4 C5 C6 C7 C8 C9 C10 C11 C12 C13 C14 | 84.71 ± 1.39 89.82 ± 1.30 86.82 ± 1.10 84.68 ± 1.78 86.93 ± 1.10 84.14 ± 1.92 84.51 ± 2.05 92.77 ± 1.19 89.67 ± 1.14 88.30 ± 1.64 90.65 ± 1.27 87.02 ± 1.13 92.81 ± 1.11 85.41 ± 2.36 | 88.81 ± 2.01 95.01 ± 1.18 91.97 ± 1.39 86.41 ± 1.21 88.37 ± 1.40 79.89 ± 2.13 85.91 ± 1.51 96.15 ± 0.75 91.45 ± 1.38 88.52 ± 1.85 87.88 ± 1.44 86.47 ± 1.62 90.21 ± 1.31 85.06 ± 1.49

Table S2 shows results of training the algorithm with young people and validating with two groups: young and elderly people (paper Table V).

TABLE S2
SENSITIVITY (SE), SPECIFICITY (SP) AND ACCURACY (AC) AFTER TRAINING WITH YOUNG ADULTS AND VALIDATING EITHER WITH YOUNG ADULTS (355 TRIALS) OR ELDERLY PEOPLE (968 TRIALS).
Feature | Young | Elderly
SE | SP | AC | SE | SP | AC
C1 C2 C3 C4 C5 C6 C7 C8 C9 C10 C11 C12 C13 C14 | 93.79 ± 1.92 94.28 ± 1.88 98.53 ± 0.85 95.50 ± 1.30 97.13 ± 1.65 81.80 ± 3.04 83.73 ± 2.24 95.54 ± 1.24 97.80 ± 1.62 91.97 ± 2.31 88.47 ± 3.29 95.64 ± 1.15 92.56 ± 1.20 81.75 ± 3.09 | 78.97 ± 4.60 96.13 ± 1.22 80.50 ± 3.26 75.41 ± 3.62 81.40 ± 2.48 87.96 ± 2.06 87.73 ± 2.45 96.38 ± 1.43 80.70 ± 3.35 80.18 ± 3.34 93.83 ± 1.01 73.44 ± 3.77 94.41 ± 1.50 90.87 ± 2.28 | 86.38 ± 2.37 95.21 ± 1.17 89.51 ± 1.84 85.45 ± 2.14 89.27 ± 1.23 84.88 ± 1.88 85.73 ± 1.43 95.96 ± 0.72 89.25 ± 1.96 86.08 ± 1.38 91.15 ± 1.77 84.54 ± 1.95 93.49 ± 0.86 86.31 ± 2.32 | 76.00 77.33 84.00 66.67 89.33 52.00 66.67 85.33 88.00 82.67 68.00 73.33 62.67 58.67 | 96.42 97.65 96.42 85.33 76.48 89.36 91.27 98.10 96.42 94.29 93.84 91.94 95.19 86.00 | 86.21 87.49 90.21 76.00 82.91 70.68 78.97 91.72 92.21 88.48 80.92 82.64 78.93 72.33

Table S3 (corresponding to paper Table VI) shows results of validating with elderly people after training with young adults (test 1), and after training and validating exclusively with elderly people (test 2).

TABLE S3
VARIATION IN ACCURACY AND THRESHOLD T1 AFTER TRAINING EXCLUSIVELY WITH YOUNG BUT VALIDATING WITH ELDERLY PEOPLE (TEST 1), AND THEN TRAINING AND VALIDATING WITH ELDERLY PEOPLE (TEST 2).
Feature | AC [%] with elderly | Threshold T1
Test 1 | Test 2 | Test 1 | Test 2
C1 C2 C3 C4 C5 C6 C7 C8 C9 C10 C11 C12 C13 C14 | 86.21 87.49 90.21 76.00 82.91 70.68 78.97 91.72 92.21 88.48 80.92 82.64 78.93 72.33 | 84.48 ± 5.89 90.45 ± 5.19 90.85 ± 7.25 79.47 ± 4.64 82.76 ± 4.39 74.62 ± 8.48 81.62 ± 8.18 92.36 ± 6.80 92.58 ± 7.09 90.58 ± 4.36 83.44 ± 5.74 83.66 ± 7.40 80.73 ± 5.62 76.79 ± 6.20 | 1.27 ± 0.002 1.07 ± 0.029 1.48 ± 0.017 2.00 ± 0.001 0.53 ± 0.004 0.54 ± 0.014 8.08 ± 0.312 0.40 ± 0.005 0.43 ± 0.009 1.93 ± 0.020 1.36 ± 0.002 0.09 ± 5.34e-05 0.08 ± 9.35e-05 1.03 ± 0.002 | 1.04 ± 0.069 0.97 ± 0.012 1.23 ± 0.024 1.56 ± 0.112 0.27 ± 0.008 0.33 ± 0.032 4.97 ± 0.092 0.36 ± 0.003 0.36 ± 0.002 1.86 ± 0.006 1.23 ± 0.047 0.09 ± 0.001 0.07 ± 0.002 0.95 ± 0.020

Table S4 shows validation results of all 14 features with threshold T2 tested on all 38 subjects (paper Table VII)

TABLE S4
SPECIFICITY (SP) AND ACCURACY (AC) AFTER TESTING DATA FROM ALL SUBJECTS WITH THRESHOLD T2.
Feature | SP | AC
C1 C2 C3 C4 C5 C6 C7 C8 C9 C10 C11 C12 C13 C14 | 49.11 ± 4.22 32.97 ± 6.46 59.04 ± 5.56 37.66 ± 5.56 34.54 ± 7.06 7.48 ± 1.09 26.41 ± 1.63 38.34 ± 5.59 67.97 ± 2.86 39.52 ± 4.47 27.78 ± 5.24 47.64 ± 4.18 37.80 ± 3.42 24.31 ± 2.69 | 74.53 ± 2.08 66.43 ± 3.06 79.49 ± 2.71 68.80 ± 2.70 67.24 ± 3.44 53.71 ± 0.52 63.18 ± 0.80 69.14 ± 2.71 83.96 ± 1.37 69.70 ± 2.13 63.86 ± 2.53 73.79 ± 2.09 68.87 ± 1.69 62.12 ± 1.32

This section includes figures with the individual activity analysis of the other 13 features (C8 is shown in paper Fig. 4).

1

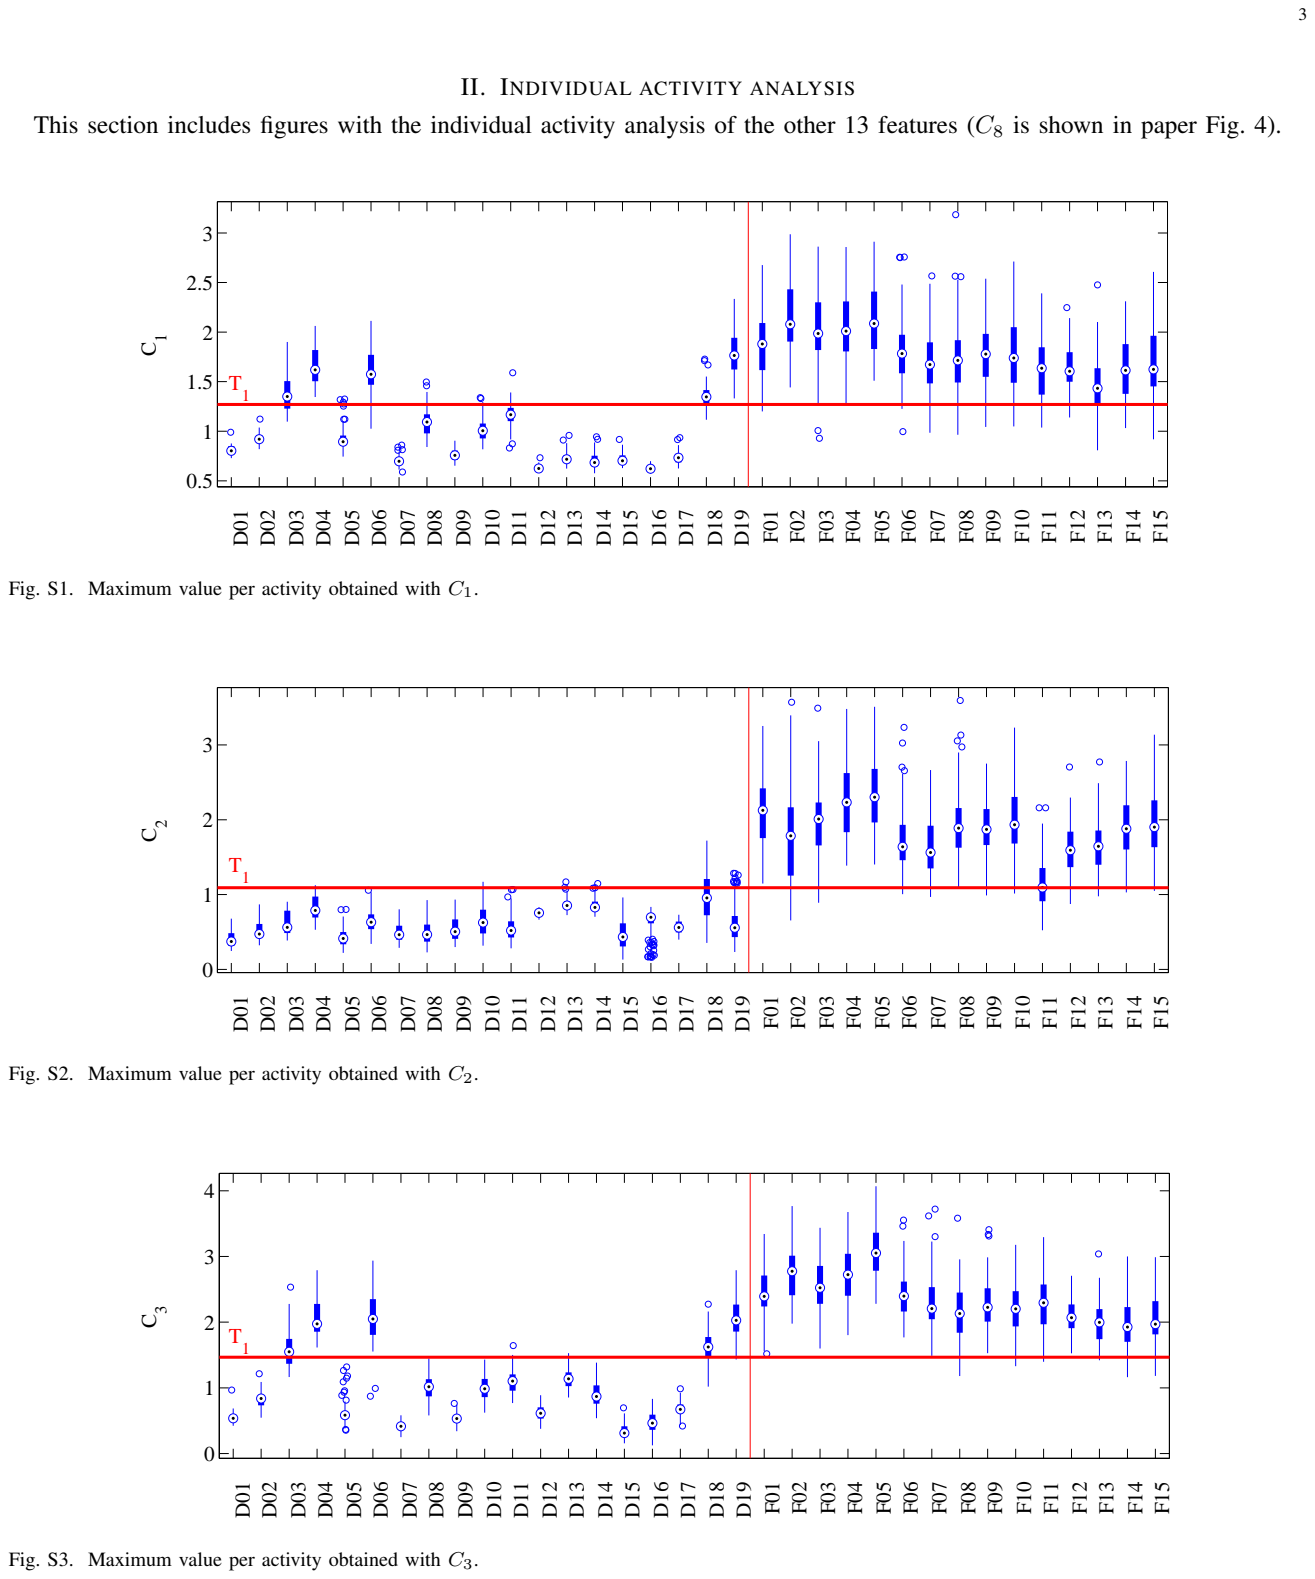
[picture p109: page 3]

II. INDIVIDUAL ACTIVITY ANALYSIS

Fig. S1. Maximum value per activity obtained with C1.

Fig. S2. Maximum value per activity obtained with C2.

Fig. S3. Maximum value per activity obtained with C3.

0.5

1

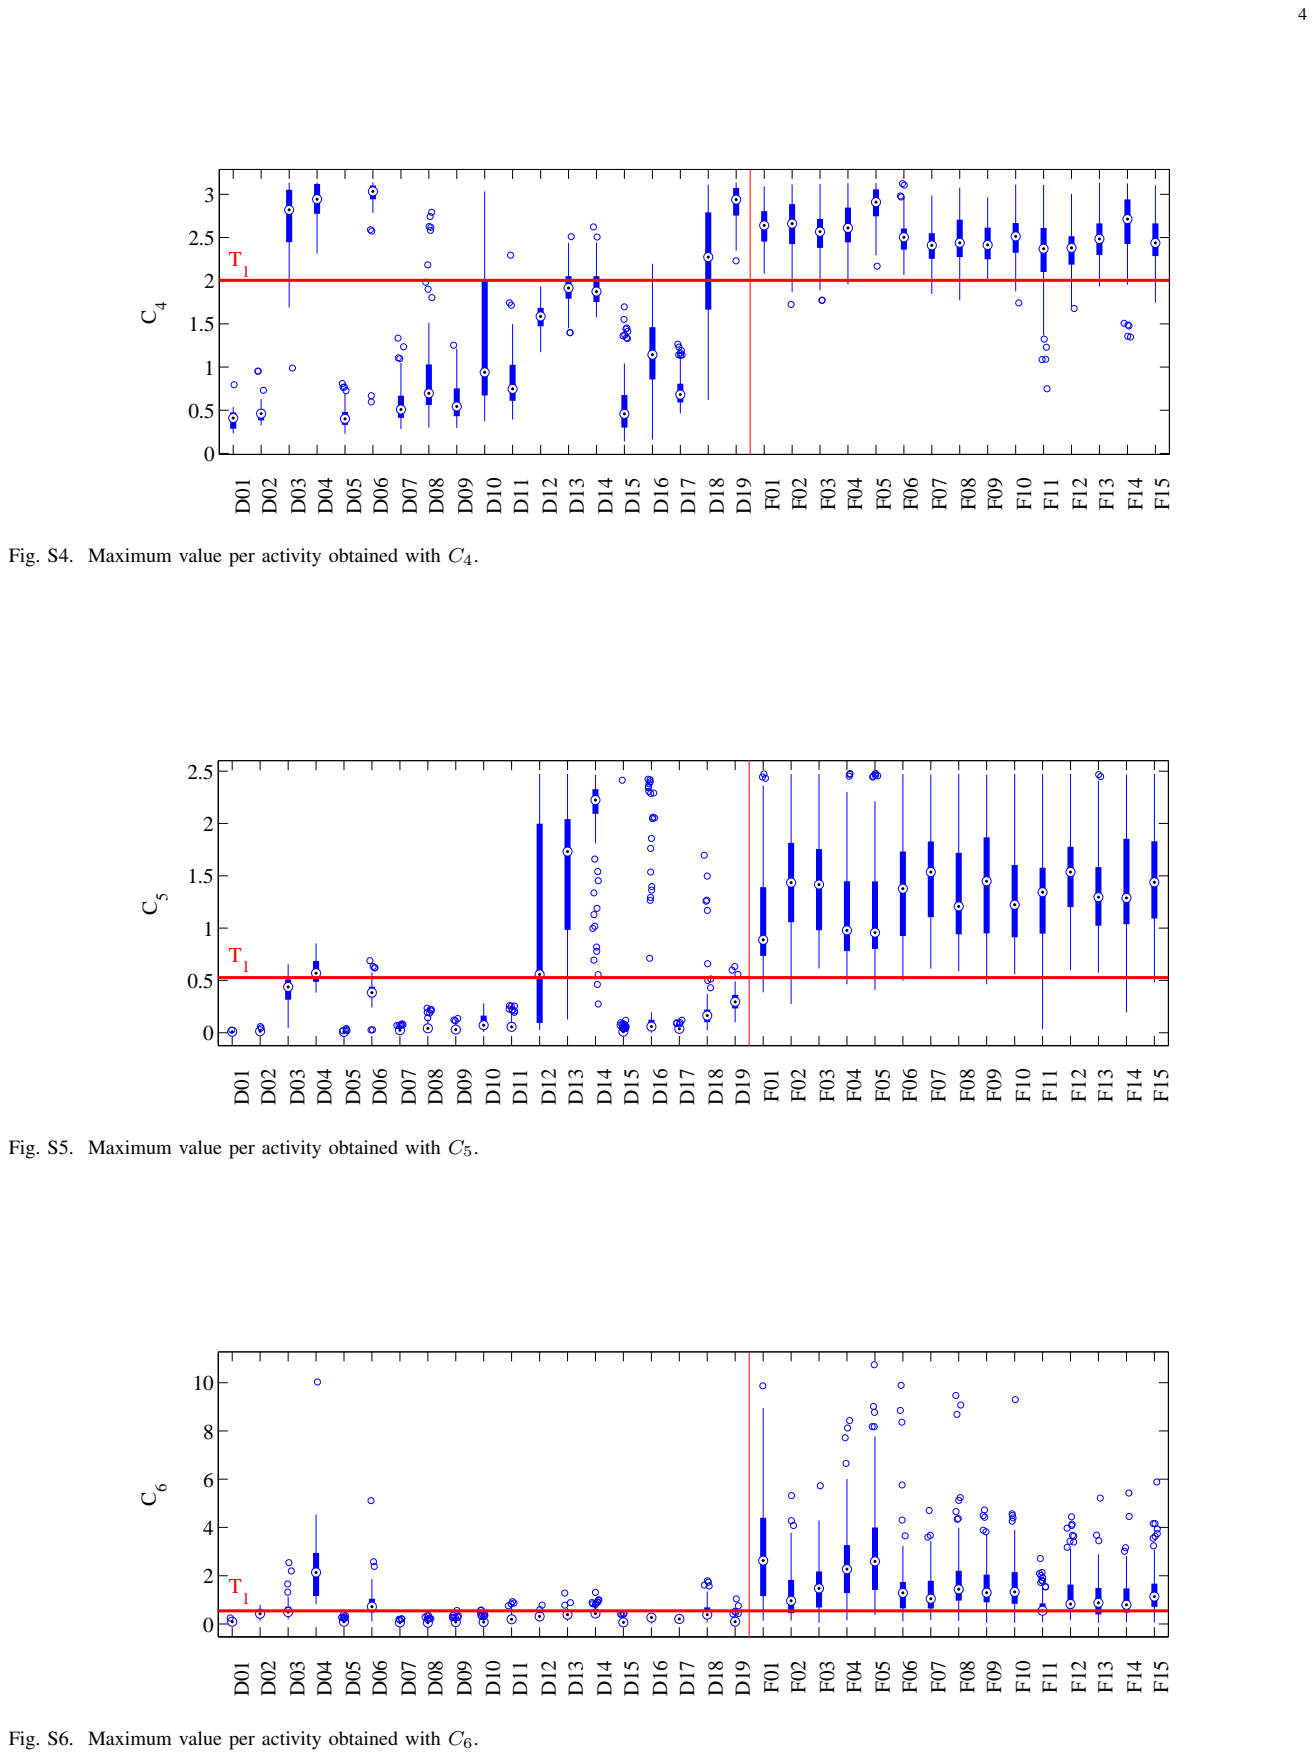
[picture p110: page 4]

Fig. S4. Maximum value per activity obtained with C4.

Fig. S5. Maximum value per activity obtained with C5.

Fig. S6. Maximum value per activity obtained with C6.

10

20

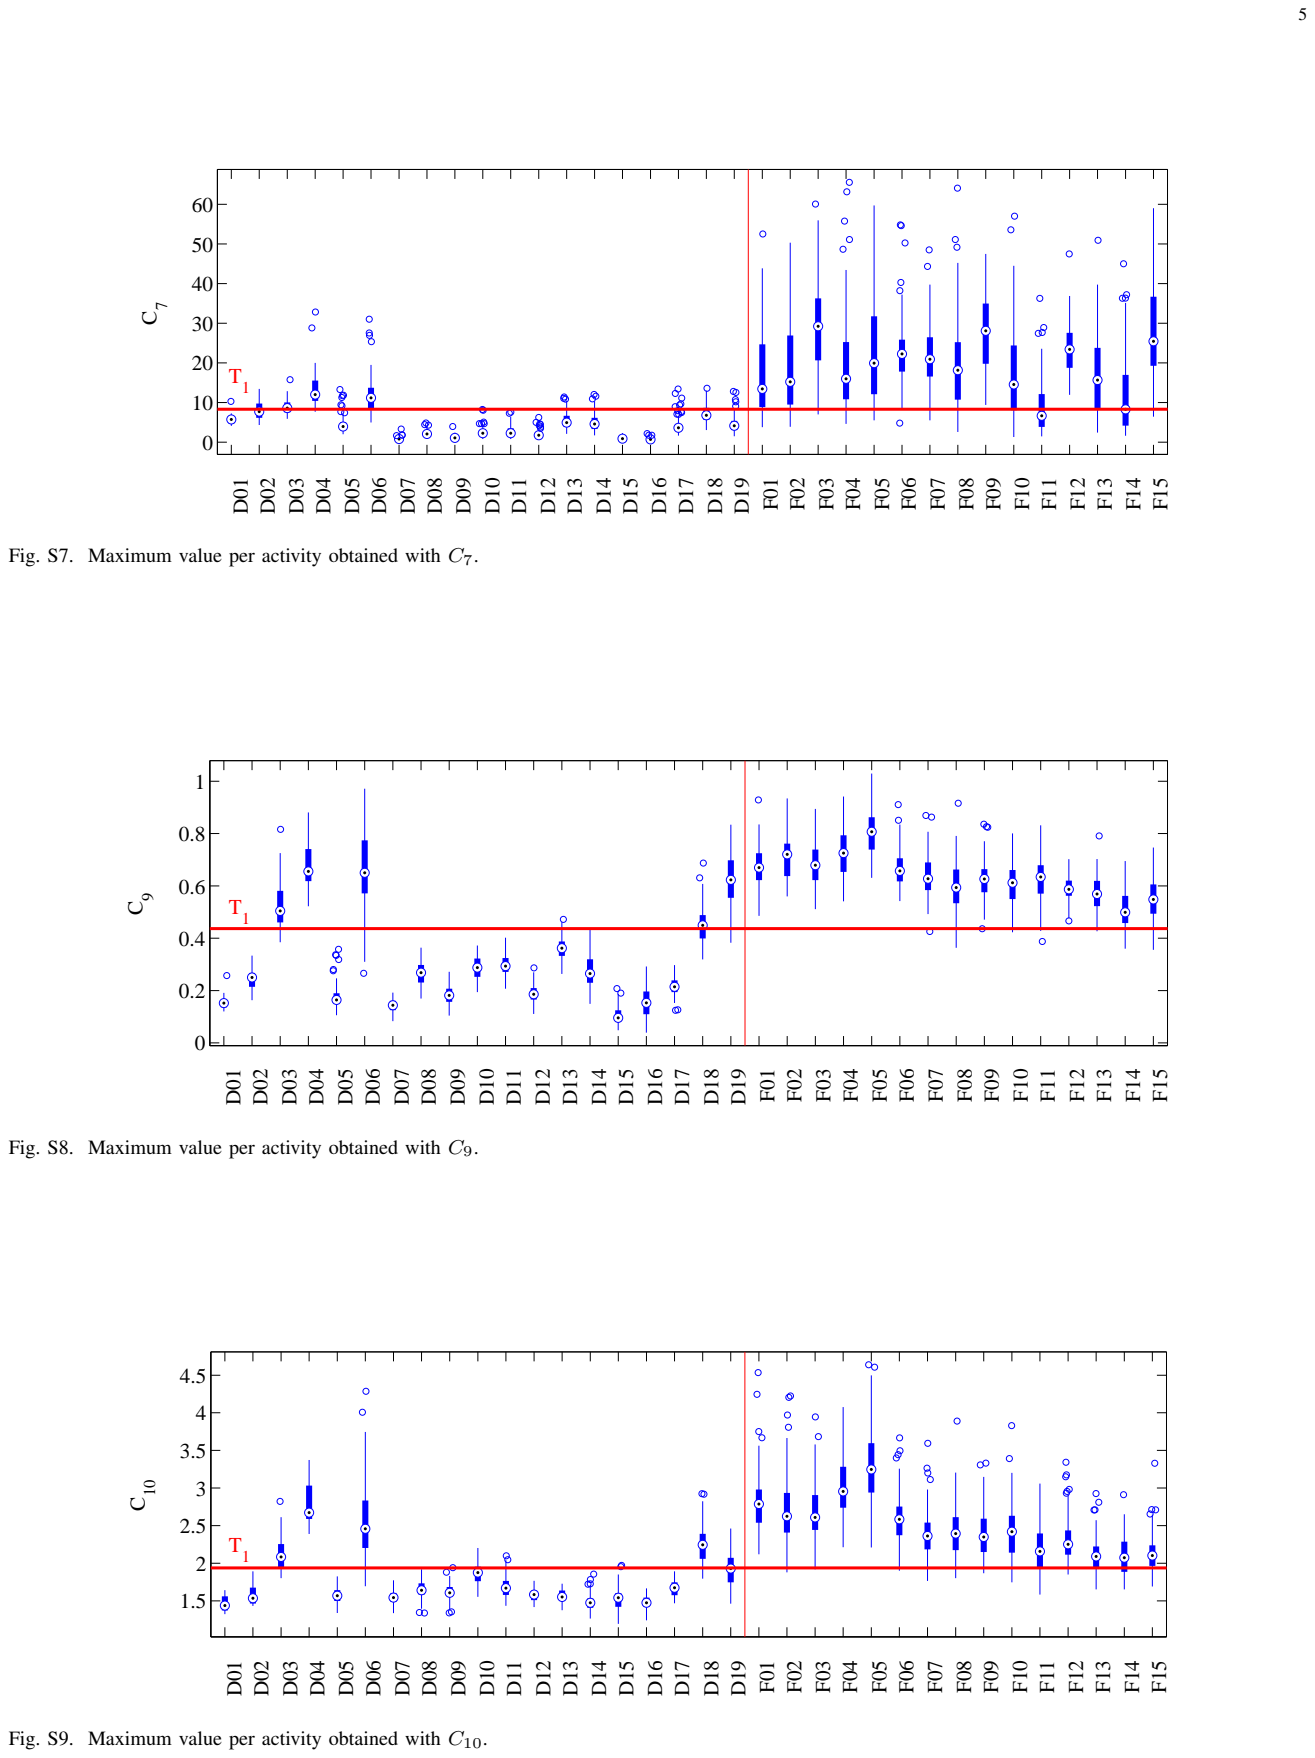
[picture p111: page 5]

Fig. S7. Maximum value per activity obtained with C7.

Fig. S8. Maximum value per activity obtained with C9.

Fig. S9. Maximum value per activity obtained with C10.

0.5

1

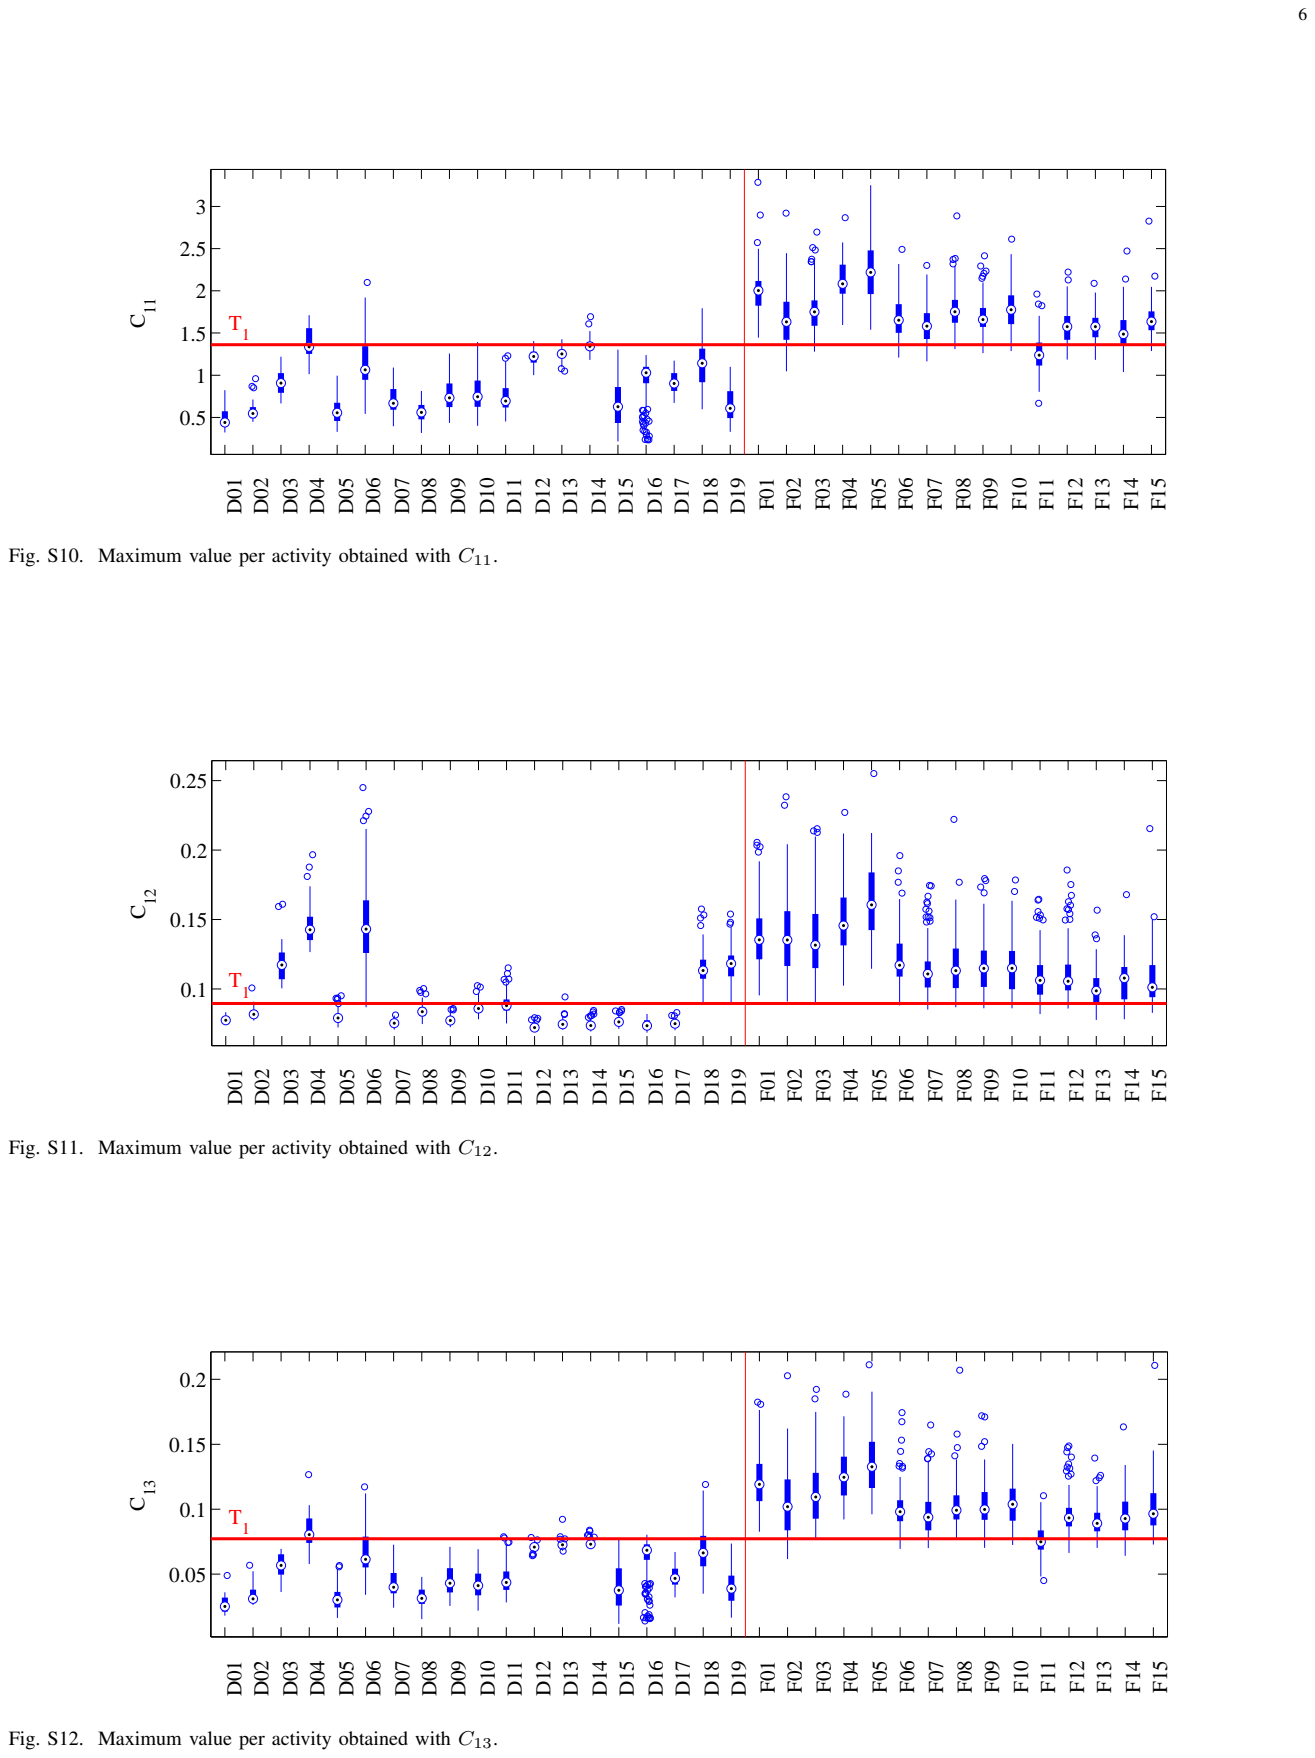
[picture p112: page 6]

Fig. S10. Maximum value per activity obtained with C11.

Fig. S11. Maximum value per activity obtained with C12.

Fig. S12. Maximum value per activity obtained with C13.

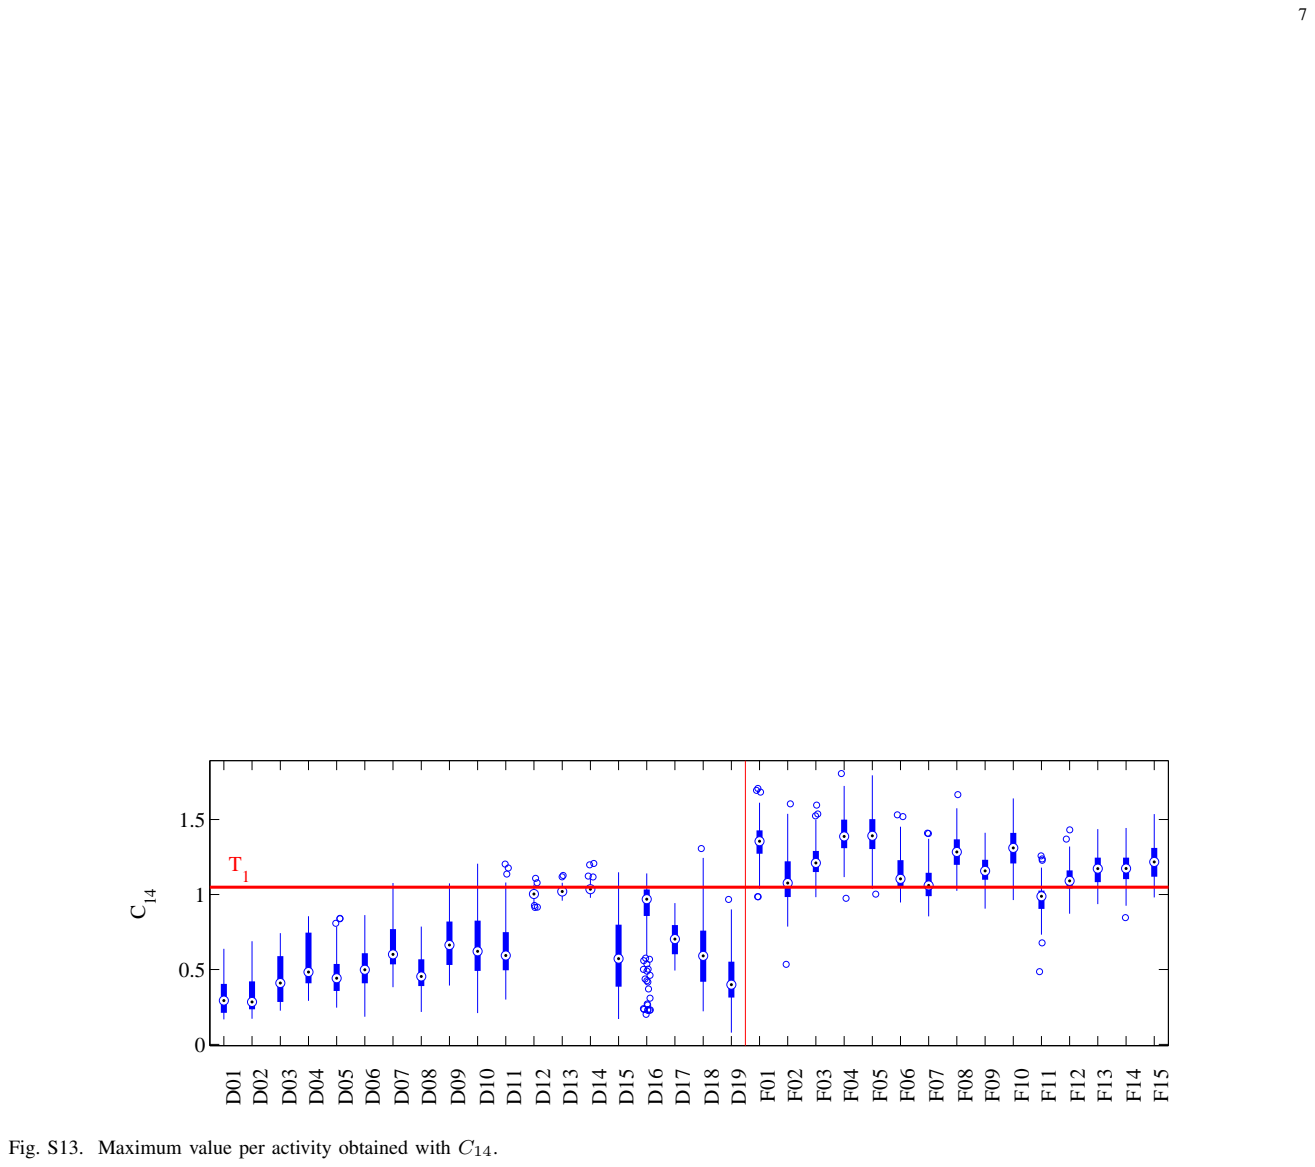
[picture p113: page 7]

Fig. S13. Maximum value per activity obtained with C14.
