KaykyCrespo/cinto-inteligente-deteccao-quedas/(list of files, drawings)

Other design files:
docs/esquemas/esquemas eletricos/antena.fzz
docs/esquemas/esquemas eletricos/cinto.fzz
