KaykyCrespo/cinto-inteligente-deteccao-quedas/Arduino/anchor_mvp_v1/credenciais_exemplo.h

// Copie este arquivo para credenciais.h (mesma pasta) e preencha com a rede 2,4 GHz.
// credenciais.h é ignorado pelo git: senhas não vão para o repositório.
#define WIFI_SSID       "NOME_DO_SEU_WIFI"
#define WIFI_PASSWORD   "SENHA_DO_SEU_WIFI"
