KaykyCrespo/cinto-inteligente-deteccao-quedas/(commit log)

2026-11-02 Ajusta firmware do cinto e da antena
    [leituras_mvp_20261101_222628.csv]
2026-11-02 Configura MPU6050 em ±8 g / ±2000 °/s e retreina o modelo
    [leituras_mvp_20261101_222628.csv]
2026-11-02 Atualiza painel para as faixas ±8 g / ±2000 °/s
2026-11-02 Reorganiza abas do painel
    [amostras_20261102_021354.csv, janelas_20261102_021354.csv]
2026-11-02 Adiciona cartões de status das antenas
2026-11-02 Corrige erro que interrompia o painel
2026-11-02 Adiciona legenda ao gráfico de probabilidade de queda
2026-11-02 Ajusta gravação de amostras em CSV
2026-11-02 Corrige gravação de amostras
    [amostras_20261102_021354.csv, janelas_20261102_021354.csv]
2026-11-02 Adiciona envio de alertas pelo Telegram
2026-11-04 Reposiciona gráfico de localização indoor
2026-11-04 Ajusta gráfico de probabilidade e confirmação de envio do Telegram
2026-11-04 Ajusta alerta de queda e gráficos
2026-11-04 Ajusta legendas e evita mensagens de alerta repetidas
2026-11-04 Ajusta gráfico de probabilidade de queda
2026-11-04 Ajusta limiar de alarme e tabela de quedas
2026-11-04 Permite desligar alertas e adiciona logo e botão de gravação
2026-11-04 Ajusta visual do alerta de queda
2026-11-04 Adiciona contagem regressiva ao cartão de alerta
2026-11-04 Reduz cartões de queda e de situação normal
2026-11-04 Adiciona tabela de histórico de quedas
2026-11-04 Desenha raios de distância das antenas no mapa
2026-11-04 Adiciona ensaio de RSSI a 1 m
    [1m 1GATT.csv, 1m 2GATT.csv, 1m 3GATT.csv, amostras_20261104_194158_p01.csv, amostras_20261104_194625_p01.csv, amostras_20261104_195117_p01.csv]
2026-11-04 Adiciona ensaio de RSSI a 1 m com GATT nas antenas em posição baixa
2026-11-04 Adiciona ensaio de RSSI a 1 m com antenas em posição alta
    [1m 1GATT ALTA.csv, 1m 1GATT BAIXO.csv, 1m 2GATT ALTA.csv, 1m 2GATT BAIXO.csv, 1m 3GATT ALTA.csv, 1m 3GATT BAIXO.csv, amostras_20261104_202353_p01.csv, amostras_20261104_202933_p01.csv]
2026-11-05 Cria banco de dados SQLite e reorganiza pastas do projeto
    [1m 1GATT ALTA.csv, 1m 1GATT BAIXO.csv, 1m 2GATT ALTA.csv, 1m 2GATT BAIXO.csv, 1m 3GATT ALTA.csv, 1m 3GATT BAIXO.csv, amostras_20261104_194158_p01.csv, amostras_20261104_194625_p01.csv]
2026-11-05 Configura ambiente de 7 m
2026-11-05 Move legenda para o lado do mapa e corrige marcador do cinto
2026-11-05 Ajusta mapa de localização
2026-11-07 Ajusta manual e roteiro e adiciona matriz de confusão, métricas e pipeline
2026-11-07 Reorganiza documentação, remove legado e ajusta painel
    - Manual do usuario (ABNT, capa/folha de rosto, formulas com legenda, passo a passo do Telegram), roteiro do video e diagramas (arquitetura, fluxograma, esquemas eletricos, pipeline, metricas)
    - READMEs renomeados (README_FIRMWARE, README_BANCO_DE_DADOS, README_ORIGEM_SISFALL); docs/ unido a DOCUMENTACAO/
    - Remove pasta legado, READMEs antigos, detector do cinto_v5 e bibliotecas Arduino nao usadas
    - Remove OQPNB como nome do projeto; PDFs sem sufixo
    - Painel: mapa sem eixos negativos, tabela de quedas vazia com cabecalho, colunas com espaco, origem ADVERTISING
    - Adiciona impressao_3d/ e requirements-docs.txt
2026-11-07 Adiciona ordem de montagem ao manual e print do alerta no Telegram
    - Manual: secao 2.5 Ordem de montagem (cinto e antena); fixacao passa a ser 2.6
    - DOCUMENTACAO/APOIO/IMAGENS/prints/telegram_alerta_queda.jpg
2026-11-07 Move credenciais para arquivos locais fora do git e detalha alerta do Telegram
    - Token e chat do Telegram via variaveis ou segredos.env (modelo: segredos.env.exemplo)
    - Wi-Fi das antenas via credenciais.h (modelo: credenciais_exemplo.h)
    - .gitignore ignora segredos.env, credenciais.h e temporarios do Word
    - Mensagem de queda mostra antena mais perto e quadrante em linhas separadas
    - Manual e READMEs atualizados
2026-11-07 Atualiza print do alerta de queda no Telegram com o novo formato
2026-11-07 Move print do alerta do Telegram para dados/prints
2026-11-07 Ajusta manual para credenciais locais (credenciais.h e segredos.env)
2026-11-07 Atualiza manual com prints do painel e imagens da documentação
2026-11-08 Atualiza figuras do manual e organiza documentação
    Numera e inclui capturas do painel no manual, reorganiza manual, vídeo, banco de dados e gerador, atualiza os caminhos do logo e da documentação. Mantém dados/ambiente.json fora do commit.
2026-11-09 Renomeia documentação para docs e simplifica interface
    Atualiza imports e referências para interface.py, move DOCUMENTACAO para docs e ajusta caminhos dos documentos e scripts. Esclarece gravação de amostras e estados do painel no manual, consolida a legenda de cores e remove resumos redundantes.
2026-11-10 docs: adiciona esquemas e fotos ao manual
    [antena.fzz, cinto.fzz]
2026-11-10 Testes realizados
    videos e dados dos testes
    [1 min andando anchor 3 17-21 a 170-22.csv, 1min andando anchor 1 15-14 a 15-15.csv, 1min andando anchor 2 17-17 a 17-18.csv, deitando 15-41.csv, quedas anchor 1 15-46.csv, quedas anchor 2 16-00.csv, quedas anchor 3 16-03.csv, sentando anchor 2 15-31.csv]
2026-11-10 docs: documenta arquivos de impressão 3D
    [Case Antena.3mf, Case Cinto.3mf]
2026-11-11 Testes 1,3,5,7m
    Dados do testes de RSSI/DBM com diferentes metragens
    [teste 1m.csv, teste 2m.csv, teste 3m.csv, teste 5m.csv, teste 7m.csv]
2026-11-12 docs: organiza ensaios RSSI e consolida resultados por distância
    [1m 1GATT BAIXO.csv, 1m 2GATT BAIXO.csv, 1m 3GATT BAIXO.csv, Teste 1m GATT na Anchor1.csv, Teste 1m GATT na Anchor2.csv, Teste 1m GATT na Anchor3.csv]
2026-11-12 docs: revisa gráficos e metodologia das métricas para o TCC
2026-11-12 docs: revisa manual, move impressao_3d para docs e inicia parte escrita
    - Revisao academica do manual, com versao _Revisado em DOCX/PDF e relatorio de revisao
    - Gerador: sumario com subsecoes, fontes das figuras, paginacao, quadros/tabelas e referencias
    - Projetos 3MF movidos para docs/impressao_3d e caminhos atualizados no manual e README
    - Secao 5.6 do manual com os videos de dados/testes como evidencia qualitativa
    - Documento preparatorio PARTE_ESCRITA_FINAL e planilha de custos sem precos
    - Gravacoes e videos do roteiro tecnico e apoio da parte escrita
    [Case Antena.3mf, Case Cinto.3mf, PARTE_ESCRITA_FINAL_CUSTOS.csv]
2026-11-13 Atualiza manual, custos e parte escrita preparatoria
    - Lanca precos informados pela equipe na planilha e na Tabela 2 (minima R$ 250,79; ampliada R$ 497,67)
    - Fichamento dos seis artigos indicados e Apendice B com a declaracao de IA
    - Retira do manual a declaracao de IA, a secao de pendencias, o aviso de validacao eletrica e as fotos de montagem e multimetro; renumera figuras (14) e quadros (22)
    - Reorganiza docs/IMAGENS com fotos dos cases do cinto e da antena para a parte escrita
    - Atualiza relatorio de revisao academica e roteiro do video
    [PARTE_ESCRITA_FINAL_CUSTOS.csv]
2026-11-13 Adiciona documentos de apoio do cinto e da antena
